harrisontidy/pickleball-robot/SCHEMATIC_GUIDE.md

# Pickleball robot controller schematic guide

This guide describes revision **R2-MULTISHEET**. The source of truth is `generate_kicad_multisheet.py`; the generated KiCad project is `pickleball_robot_controller.kicad_pro`.

## Sheet map

1. `00_battery_safety.kicad_sch` — XT60, main fuse, LTC4365 whole-board cutoff, E-stop relay wiring, actuator TVS, and battery ADC.
2. `01_power_and_pi.kicad_sch` — 5 V logic supply and 5.1 V Raspberry Pi supply.
3. `02_esp32_and_pi.kicad_sch` — ESP32-PICO-KIT V4.1 carrier, Pi UART/control header, fault aggregation, optional I2C links, status LEDs, and debug points.
4. `03_left_motor.kicad_sch` — left VNH5019 driver, branch fuse, current-sense protection, motor/encoder connector, and large motor-wire pads.
5. `04_right_motor.kicad_sch` — right channel, matching the left channel.
6. `05_encoder_inputs.kicad_sch` — filtered encoder 3.3 V rail, cable resistors, four Schmitt buffers, local bypass capacitors, and test points.
7. `06_arm_servos.kicad_sch` — 6 V servo buck, PCA9685, three AHCT level buffers, and three independent PWM outputs.
8. `07_main_servo_8v4.kicad_sch` — dedicated 8.4 V rail for the Miuzei main-swing servo.

J1 uses the KiCad AMASS XT60PW-M footprint's actual polarity: pin 1 is negative/GND and pin 2 is positive/BAT_RAW. Do not reverse these to match a generic two-pin connector convention.

## Canonical ESP32 pin map

| Function | ESP32 GPIO |
|---|---:|
| PCA9685 SDA / SCL | 21 / 22 |
| Raspberry Pi UART RX / TX | 18 / 19 |
| Aggregated motor fault | 23 |
| Servo PWM output-enable | 32 |
| Left PWM / INA / INB | 25 / 26 / 27 |
| Right PWM / INA / INB | 14 / 13 / 4 |
| Battery ADC | 33 |
| Left / right current ADC | 36 / 39 |
| Left encoder A / B | 34 / 35 |
| Right encoder A / B | 37 / 38 |

GPIO2 is no longer used for servo OE, GPIO5 is deliberately unused, and UART0 GPIO1/3 remains free for the board's USB programming bridge.

## Raspberry Pi headers

J9 is the high-current Pi power connector: pins 1–2 are `PI_5V`, pins 3–4 are ground. It is a Molex Mini-Fit Jr 2x2 right-angle header. The Pi must not be powered from USB-C at the same time.

J10 is a normal 1x8 2.54 mm header:

| J10 | Signal | Raspberry Pi connection |
|---:|---|---|
| 1 | GND | any Pi ground |
| 2 | GND | second return wire |
| 3 | Pi TX to ESP GPIO18 | GPIO14, physical pin 8 |
| 4 | ESP GPIO19 to Pi RX | GPIO15, physical pin 10 |
| 5 | `SERVO_POWER_ENABLE` | GPIO17, physical pin 11 |
| 6 | aggregated motor fault | GPIO27, physical pin 13 |
| 7 | optional I2C SDA | GPIO2, physical pin 3; DNP R43 must be fitted |
| 8 | optional I2C SCL | GPIO3, physical pin 5; DNP R44 must be fitted |

J20 is a DNP bench override connected through R46 4.7 kΩ, so it cannot hard-short a Pi GPIO driven low. Leave it unpopulated for normal Pi control.

On Raspberry Pi 5, enable the primary UART with `dtoverlay=uart0-pi5` and disable the Linux serial console before using J10. Never assume the Pi 5 UART mapping matches older Pi models.

## Wheel-motor connections

J4 and J5 are JST-PH 2.00 mm six-pin headers matching the photographed cable order:

| Pin | Wire | Function |
|---:|---|---|
| 1 | red | motor OUTA |
| 2 | black | encoder ground |
| 3 | yellow | encoder A |
| 4 | green | encoder B |
| 5 | blue | filtered encoder 3.3 V |
| 6 | white | motor OUTB |

J15/J16 are the primary 1.7 mm through-hole motor-power pads. JST-PH motor pins 1/6 are isolated by normally-open JP1–JP4 solder jumpers. Leave the jumpers open with heavy motor wires; bridge them only for low-current bench tests. Fit external C18/C19 directly across each motor's red/white terminals.

Each driver has a 5 A mini-blade branch fuse, 10 kΩ safe-state pull-downs, 1 kΩ control resistors, separate diagnostics, 35 V local bulk plus ceramic bypass, and a protected current ADC. The VNH5019 custom footprint keeps exposed pads 31, 32, and 33 electrically separate and gives each its own windowed paste and thermal-via field.

## Servo system

U5 is a PCA9685. LED0, LED1, and LED2 generate independent commands; all three share a 50 Hz frame rate but can have different pulse widths.

| Header | Servo | Power | Pin order |
|---|---|---:|---|
| J12 | Miuzei 25KG 270° main swing | 8.4 V | 1 GND, 2 power, 3 PWM |
| J13 | MG996R elbow | 6 V | 1 GND, 2 power, 3 PWM |
| J14 | MG90S wrist | 4.85 V | 1 GND, 2 power, 3 PWM |

These hobby servos contain an internal control loop and position sensor, but they do not return their measured position to the ESP32 through the normal three-wire connector.

`SERVO_POWER_ENABLE` defaults low and controls both servo-regulator EN pins. PCA9685 OE also defaults disabled. This gives two startup safeguards: no servo power until the Pi enables it, and no PWM until the ESP32 enables outputs.

U13–U15 are SN74AHCT1G125 buffers powered from `WRIST_4V85`. AHCT inputs accept the PCA9685's 3.3 V high level and produce 4.85 V PWM at every servo header. Their active-low OE pins share `GPIO32_SERVO_OE`, so they are high-impedance whenever the PCA outputs are disabled; removing servo power also removes buffer power.

## Power rails

- `BAT_FUSED`: battery voltage immediately after F1.
- `VBAT_SW`: whole-board protected supply after U12/Q5/Q6.
- `ACT_VBAT`: battery supply after the external latching E-stop loop, used by motors and both servo regulators.
- `+5V_CTRL`: ESP32 and logic only.
- `PI_5V`: approximately 5.1 V, up to 5 A design target.
- `SERVO_6V`: 6.0 V rail for J13 and input to the wrist LDO.
- `WRIST_4V85`: dedicated fused 4.85 V rail for J14 MG90S.
- `MAIN_SERVO_8V4`: 8.4 V rail for J12.
- `ENC_3V3`: ferrite-filtered encoder supply.

U12 disconnects below approximately 9.62 V, reconnects near 10.10 V, and trips overvoltage near 13.79 V. It is a whole-pack discharge cutoff, not a balance charger or per-cell BMS. The TPS54560 networks use corrected feedback, EN, catch-diode, and compensation connections. C30/C40/C61 and the three RC snubbers are real KiCad DNP parts; do not populate optional bulk/snubber parts until loop and switch-node measurements justify them.

For the E-stop, use J21.1 -> Schneider XB5AS8442 NC button -> Panasonic CB1aF-RM-12V-A-5 relay coil -> J21.2. Connect the relay NO contact across J18. This keeps high actuator current out of the push-button and makes a broken coil wire stop the actuators.

## PCB rules that are not optional

- Four-layer board strongly preferred: signal/power, solid ground, power distribution, signal/power.
- Use 2 oz outer copper if practical.
- Keep every buck input-capacitor/IC/diode loop extremely small; keep switch nodes away from ESP antenna, UART, ADC, and encoder traces.
- Use Kelvin feedback routing from the output-capacitor node.
- Put the ESP antenna beyond the board edge if possible. The footprint enforces F/B keepouts; also create matching inner-layer keepouts when the four-layer PCB is created.
- Use separate high-current actuator branches from a star point; do not route motor/servo return current through the logic ground path.
- Widen motor and rail copper with pours, not only traces. Verify current width using the board house's actual copper thickness and allowed temperature rise.
- Add mounting holes, motor-wire strain relief, connector pin-1 legends, fuse ratings, rail names, and polarity on silkscreen.
- Run ERC, PCB DRC, netlist comparison, Gerber inspection, drill inspection, and paste-window inspection before ordering.

## Known design gates before manufacture

1. Measure actual motor stall current or keep the conservative 5 A branch-fuse/copper allowance.
2. Confirm every physical connector and servo SKU against the purchased part.
3. Choose exact output MLCCs and verify their effective capacitance at 5.1 V, 6 V, and 8.4 V.
4. Bench-test U12 cutoff, reconnect, reverse isolation, Q5/Q6 temperature, and the complete E-stop relay harness.
5. Bench-test regulator startup and transient response on the first PCB with a current-limited supply and dummy loads.
6. Firmware must use calibrated current sense and a short overcurrent timeout. The 5 A motor fuses protect wiring, not the small motors.
