harrisontidy/pickleball-robot/pickleball_robot_controller.pdf

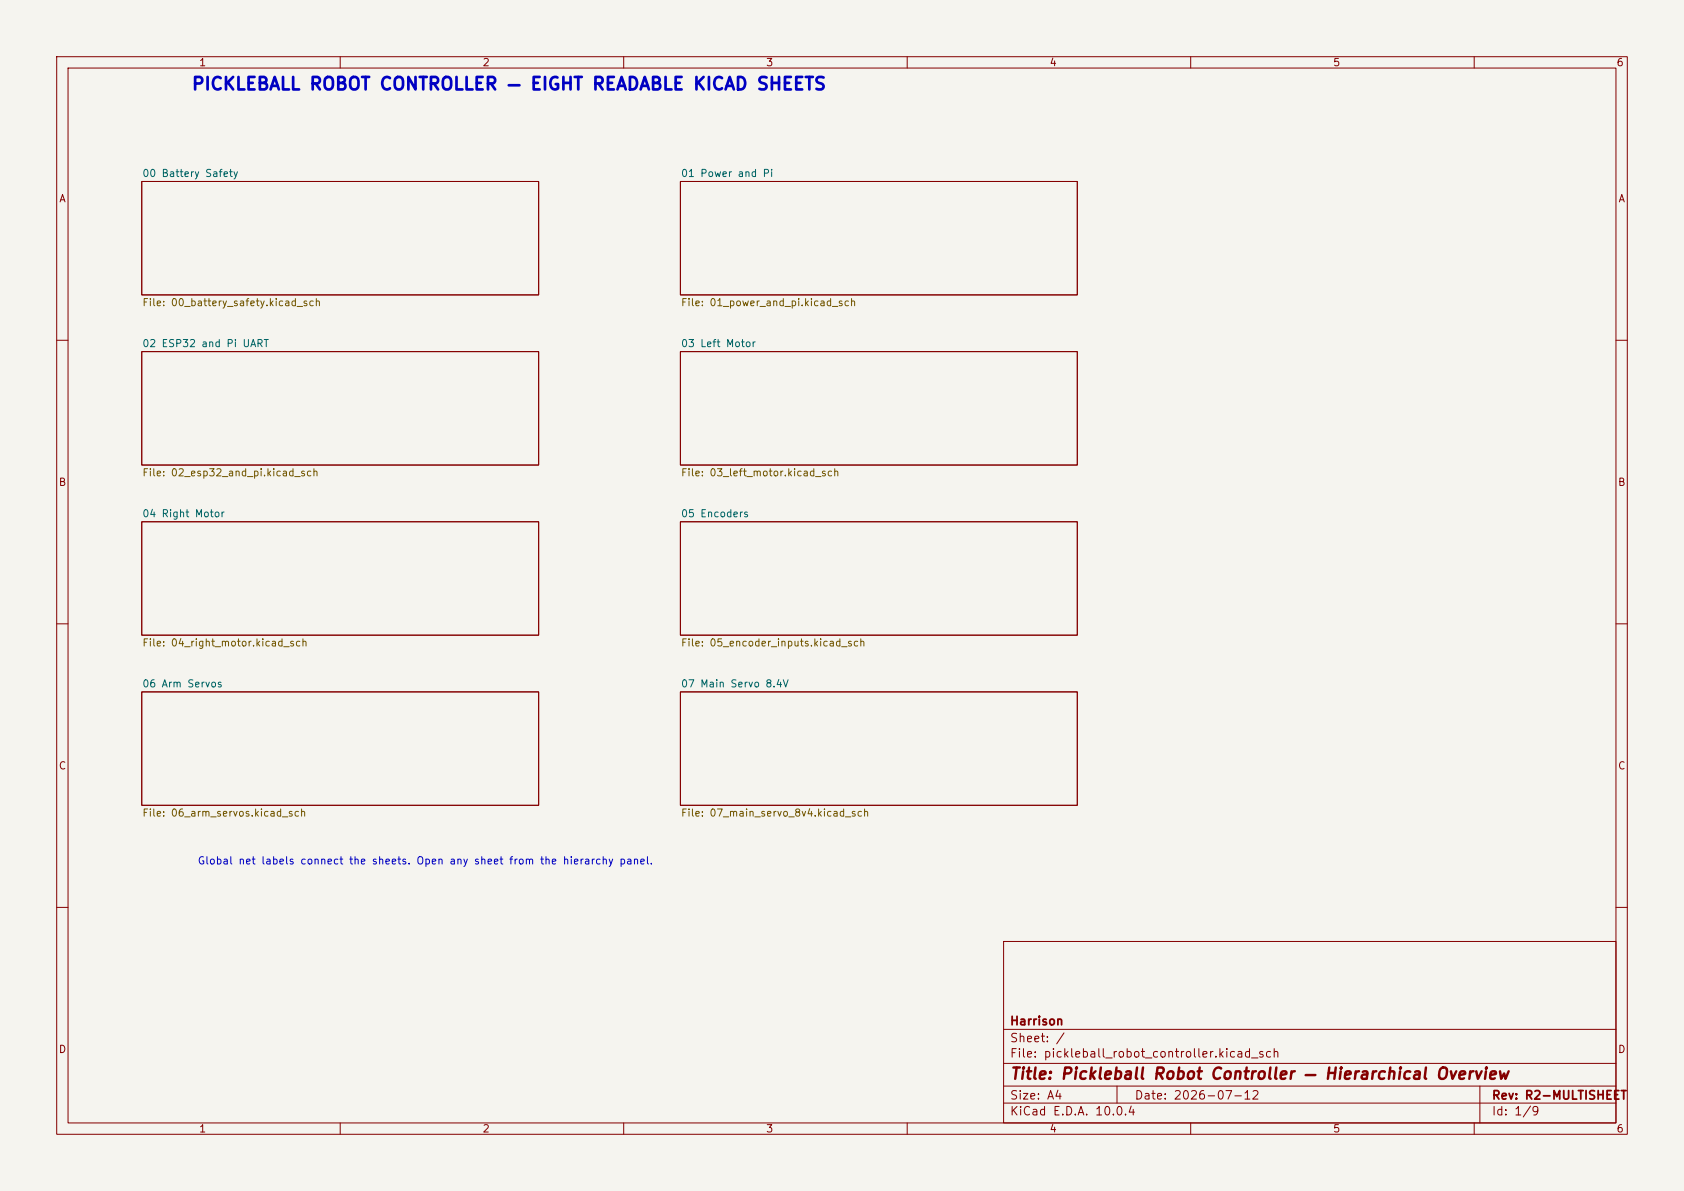
[picture p1: page 1]

01 Power and Pi File: 01_power_and_pi.kicad_sch 03 Left Motor File: 03_left_motor.kicad_sch 05 Encoders File: 05_encoder_inputs.kicad_sch 07 Main Servo 8.4V

00 Battery Safety File: 00_battery_safety.kicad_sch 02 ESP32 and Pi UART File: 02_esp32_and_pi.kicad_sch 04 Right Motor File: 04_right_motor.kicad_sch 06 Arm Servos File: 06_arm_servos.kicad_sch PICKLEBALL ROBOT CONTROLLER — EIGHT READABLE KICAD SHEETS

Global net labels connect the sheets. Open any sheet from the hierarchy panel.

Harrison
Sheet: /
File: pickleball_robot_controller.kicad_sch
Title: Pickleball Robot Controller — Hierarchical Overview
KiCad E.D.A. 10.0.4

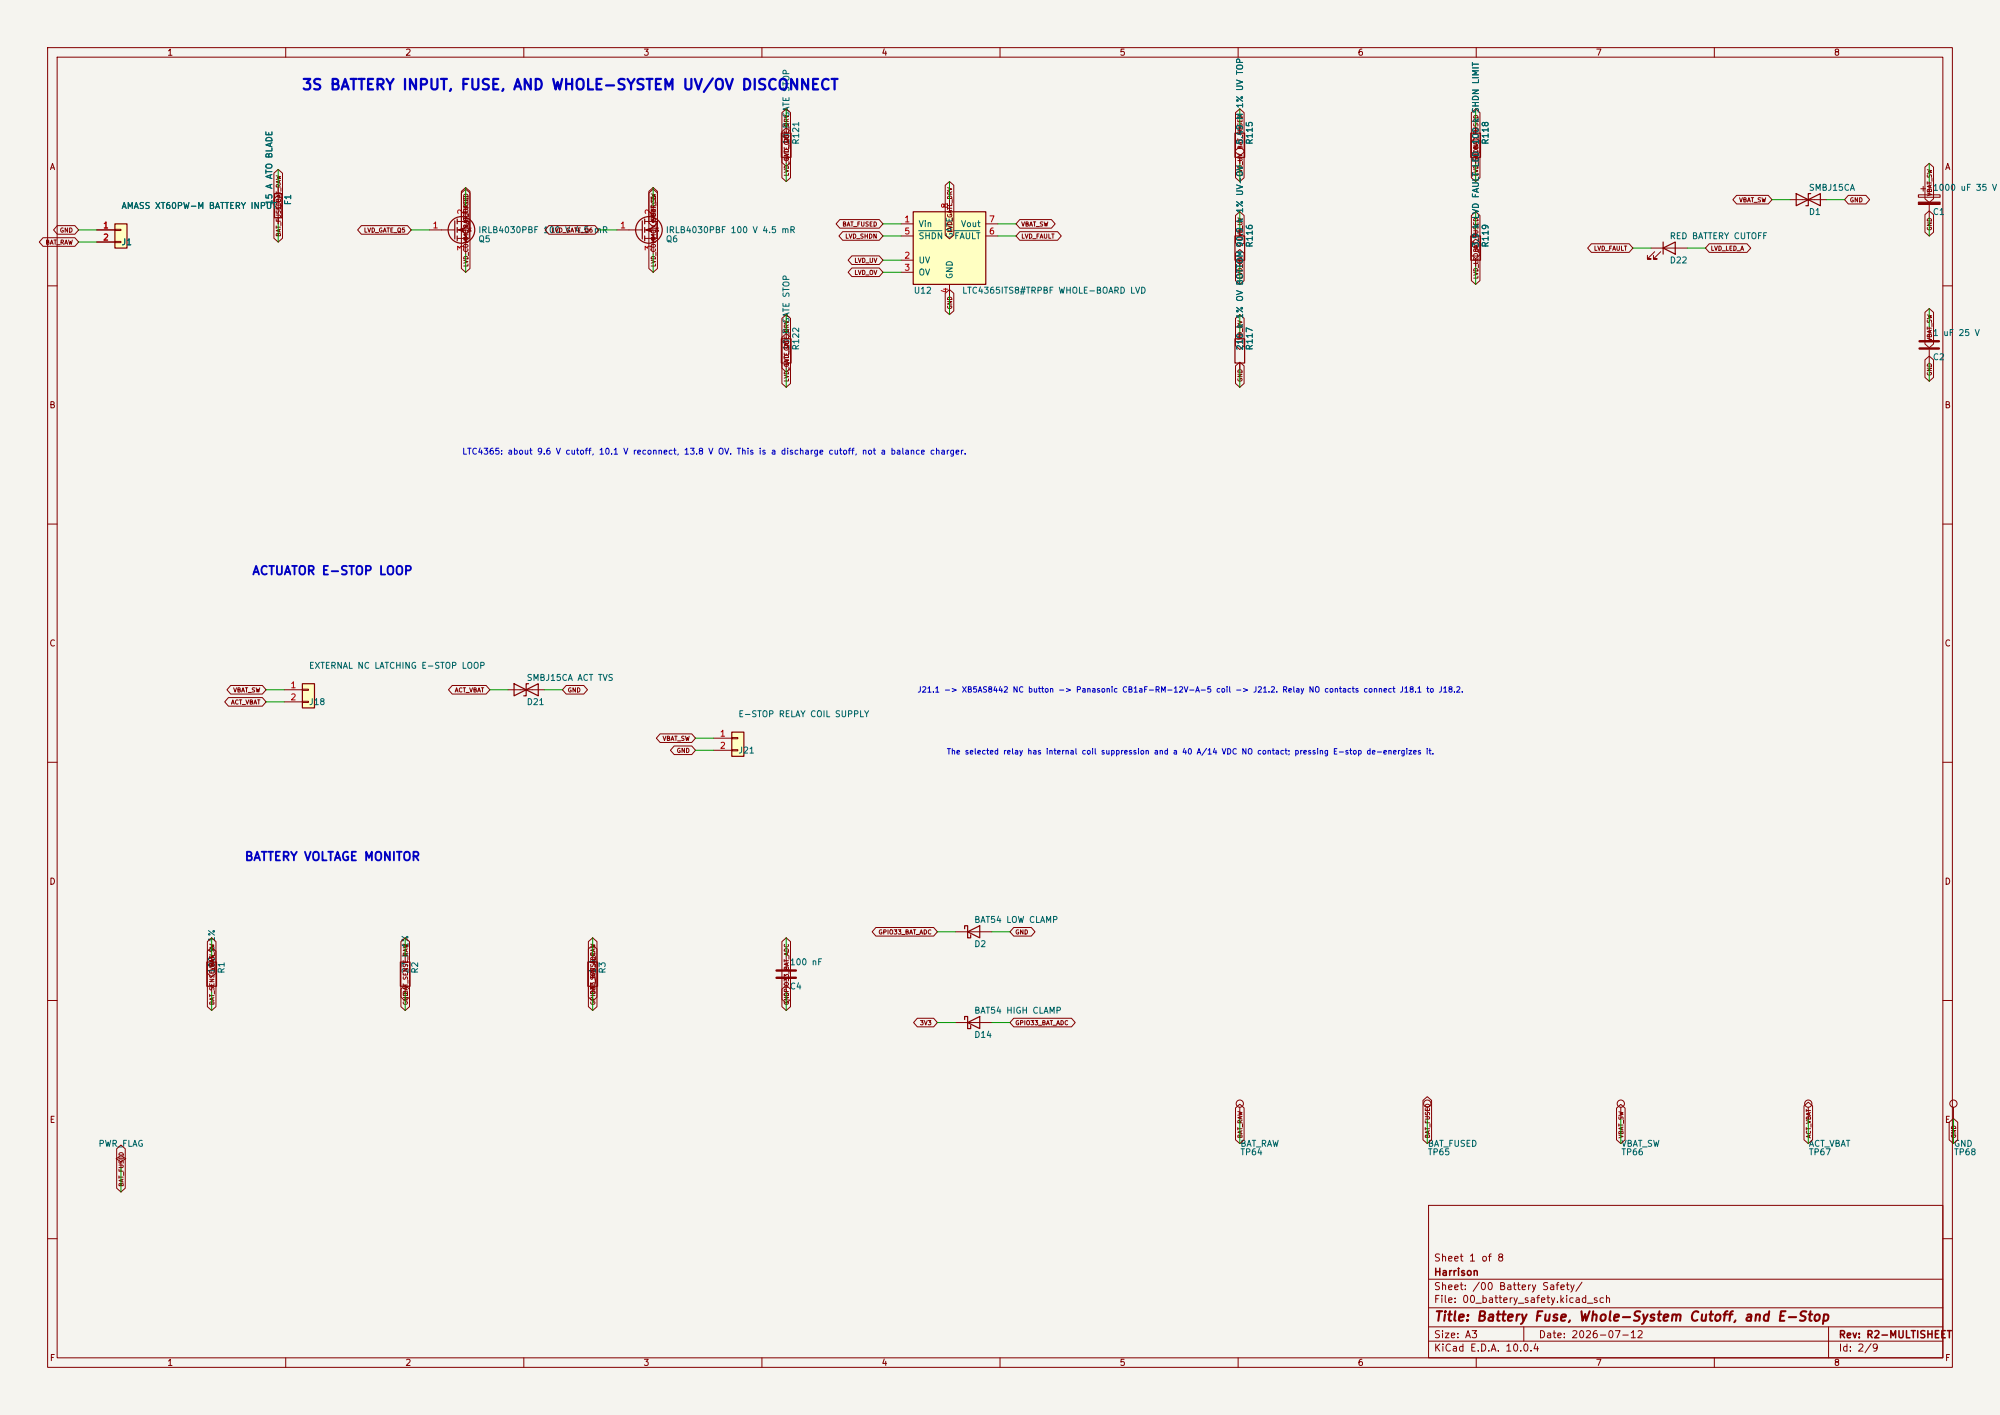
[picture p2: page 2]

J21.1 -> XB5AS8442 NC button -> Panasonic CB1aF-RM-12V-A-5 coil -> J21.2. Relay NO contacts connect J18.1 to J18.2. The selected relay has internal coil suppression and a 40 A/14 VDC NO contact; pressing E-stop de-energizes it. 3S BATTERY INPUT, FUSE, AND WHOLE-SYSTEM UV/OV DISCONNECT

LTC4365: about 9.6 V cutoff, 10.1 V reconnect, 13.8 V OV. This is a discharge cutoff, not a balance charger.

EXTERNAL NC LATCHING E-STOP LOOP

Harrison
Sheet: /00 Battery Safety/
File: 00_battery_safety.kicad_sch
Title: Battery Fuse, Whole-System Cutoff, and E-Stop

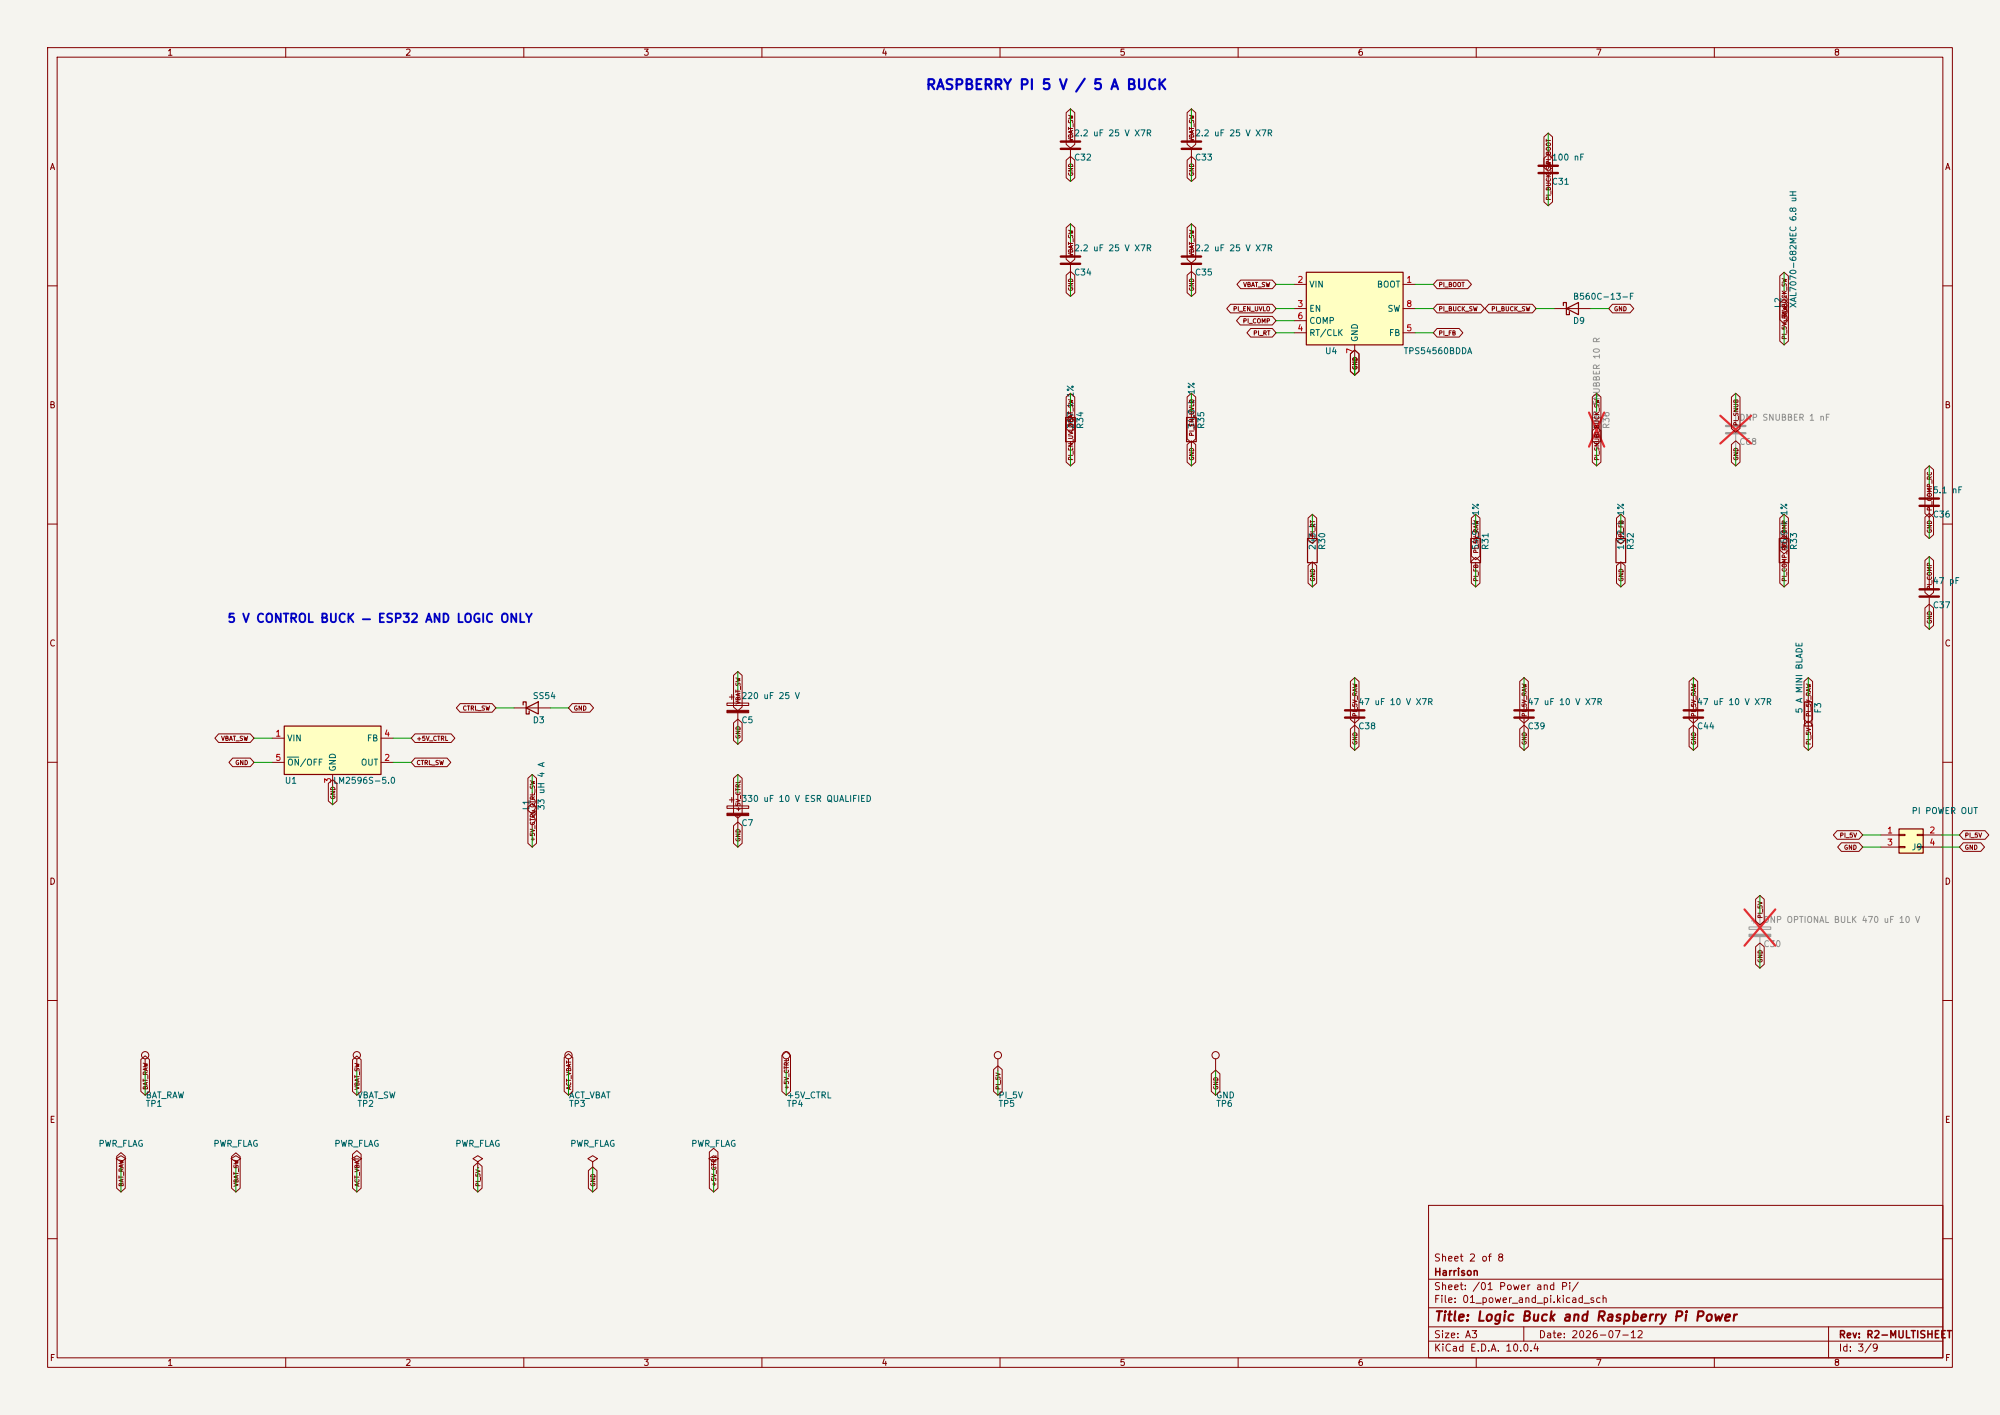
[picture p3: page 3]

k C30 DNP OPTIONAL BULK 470 uF 10 V

5 V CONTROL BUCK — ESP32 AND LOGIC ONLY

Sheet 2 of 8
Harrison
Sheet: /01 Power and Pi/
File: 01_power_and_pi.kicad_sch
Title: Logic Buck and Raspberry Pi Power

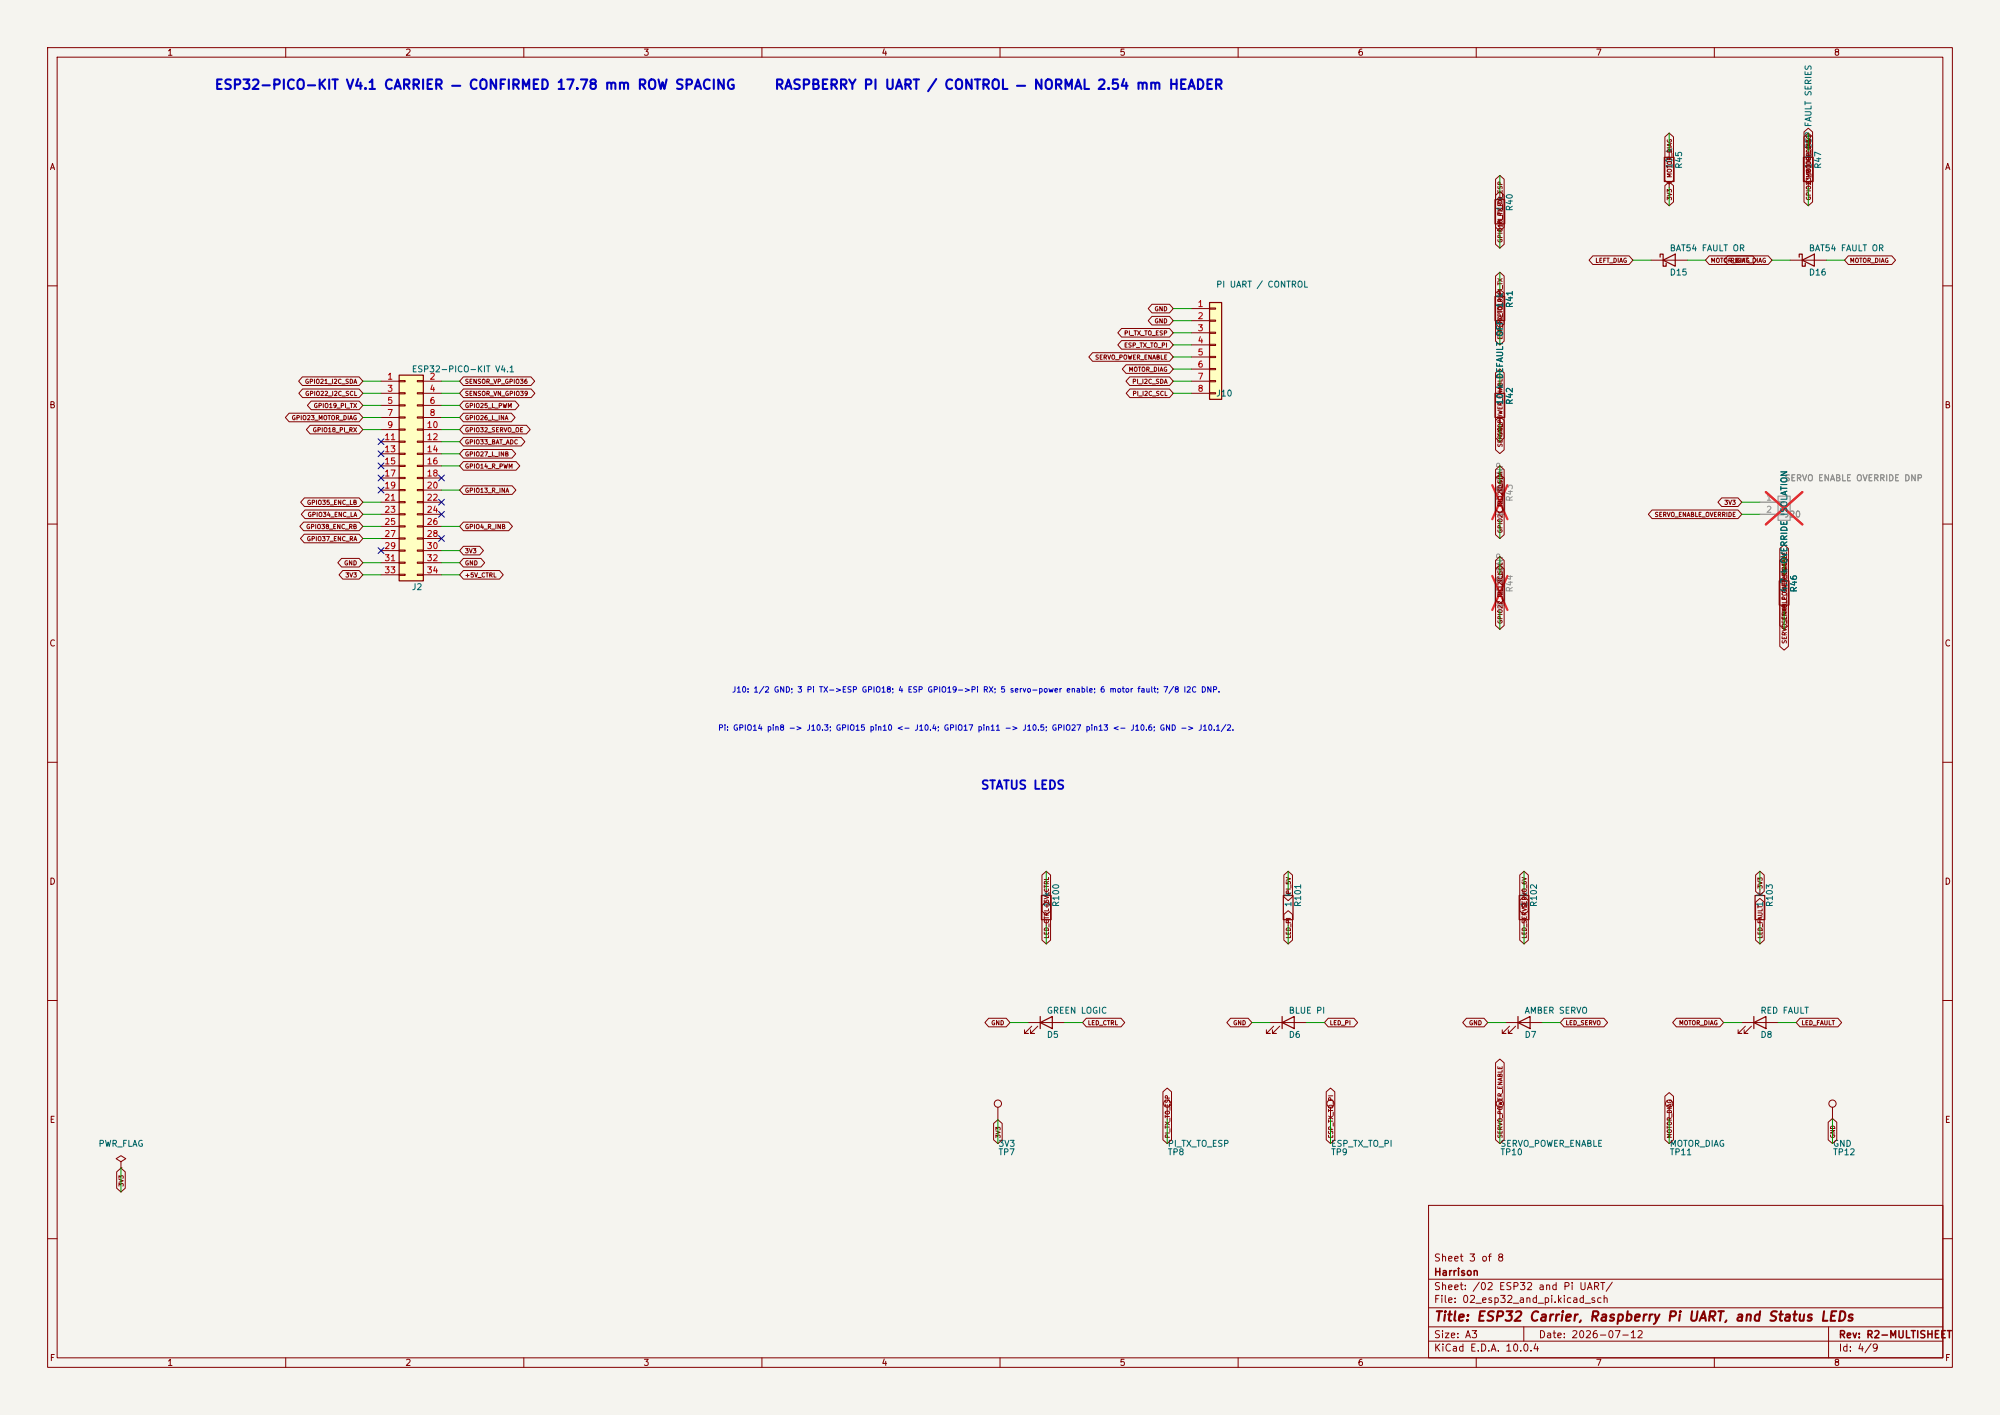
[picture p4: page 4]

SERVO ENABLE OVERRIDE DNP 1 R47k ESP FAULT SERIES 0 R44R DNP
ESP_TX_TO_PI SERVO_POWER_ENABLE MOTOR_DIAG STATUS LEDS

SERVO ENABLE OVERRIDE DNP

Pi: GPIO14 pin8 -> J10.3; GPIO15 pin10 <- J10.4; GPIO17 pin11 -> J10.5; GPIO27 pin13 <- J10.6; GND -> J10.1/2. J10: 1/2 GND; 3 Pi TX->ESP GPIO18; 4 ESP GPIO19->Pi RX; 5 servo-power enable; 6 motor fault; 7/8 I2C DNP.

Harrison
Sheet: /02 ESP32 and Pi UART/
File: 02_esp32_and_pi.kicad_sch
Title: ESP32 Carrier, Raspberry Pi UART, and Status LEDs

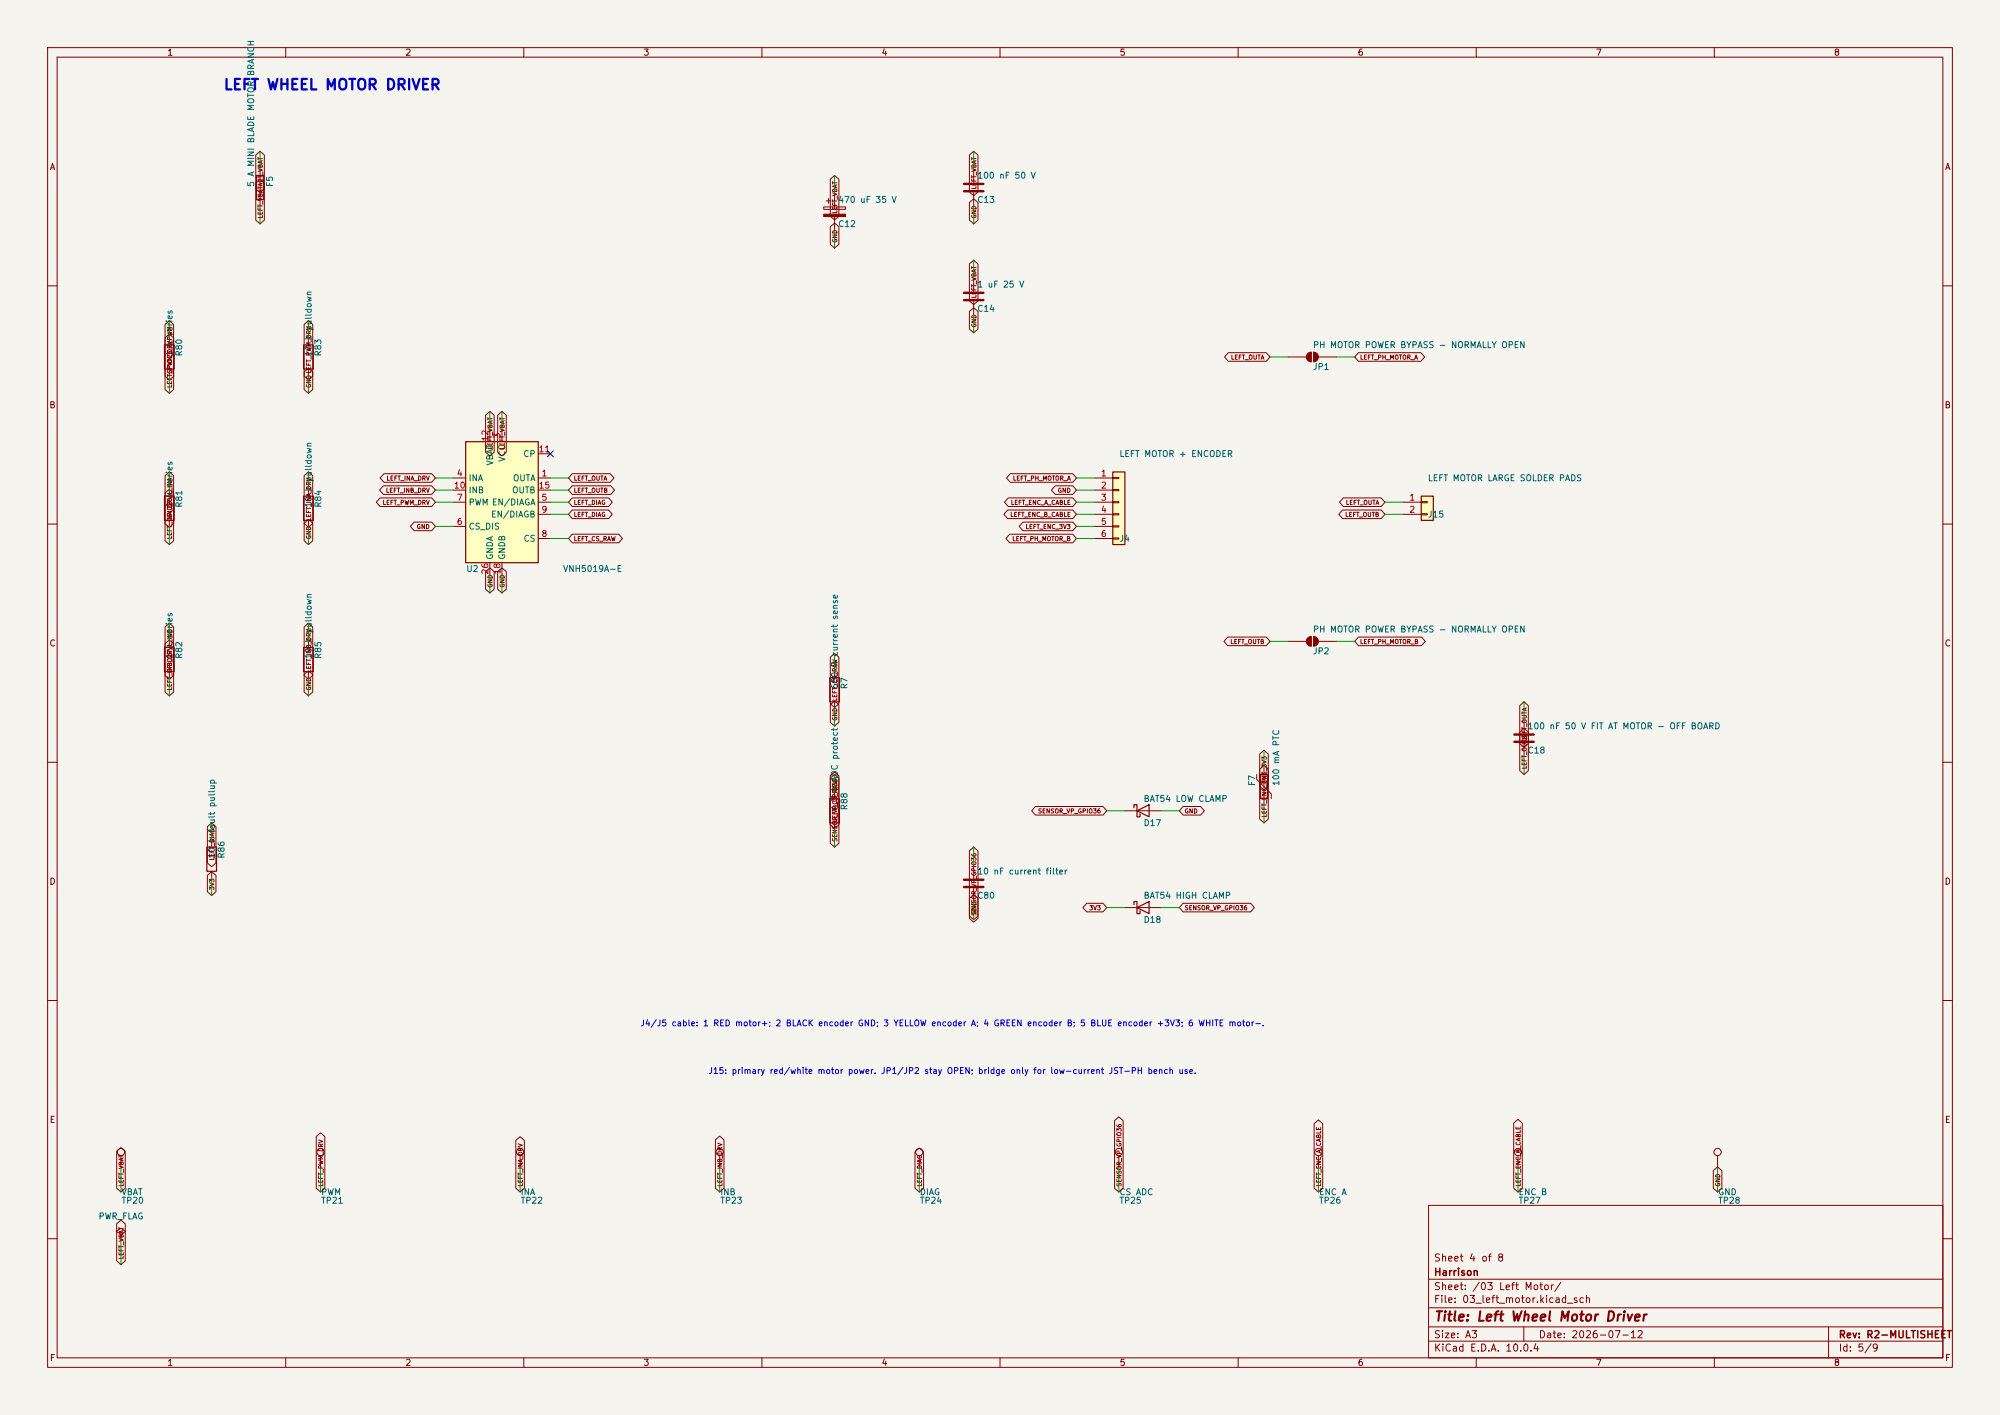
[picture p5: page 5]

LEFT WHEEL MOTOR DRIVER

LEFT MOTOR LARGE SOLDER PADS C12

100 nF 50 V FIT AT MOTOR - OFF BOARD 10 R83k pulldown 10 R84k pulldown

10 nF current filter 1 R81k series 1 R80k series

JP1 PH MOTOR POWER BYPASS - NORMALLY OPEN

JP2 PH MOTOR POWER BYPASS - NORMALLY OPEN

J4/J5 cable: 1 RED motor+; 2 BLACK encoder GND; 3 YELLOW encoder A; 4 GREEN encoder B; 5 BLUE encoder +3V3; 6 WHITE motor-. J15: primary red/white motor power. JP1/JP2 stay OPEN; bridge only for low-current JST-PH bench use.

Harrison
Sheet: /03 Left Motor/
File: 03_left_motor.kicad_sch
Title: Left Wheel Motor Driver

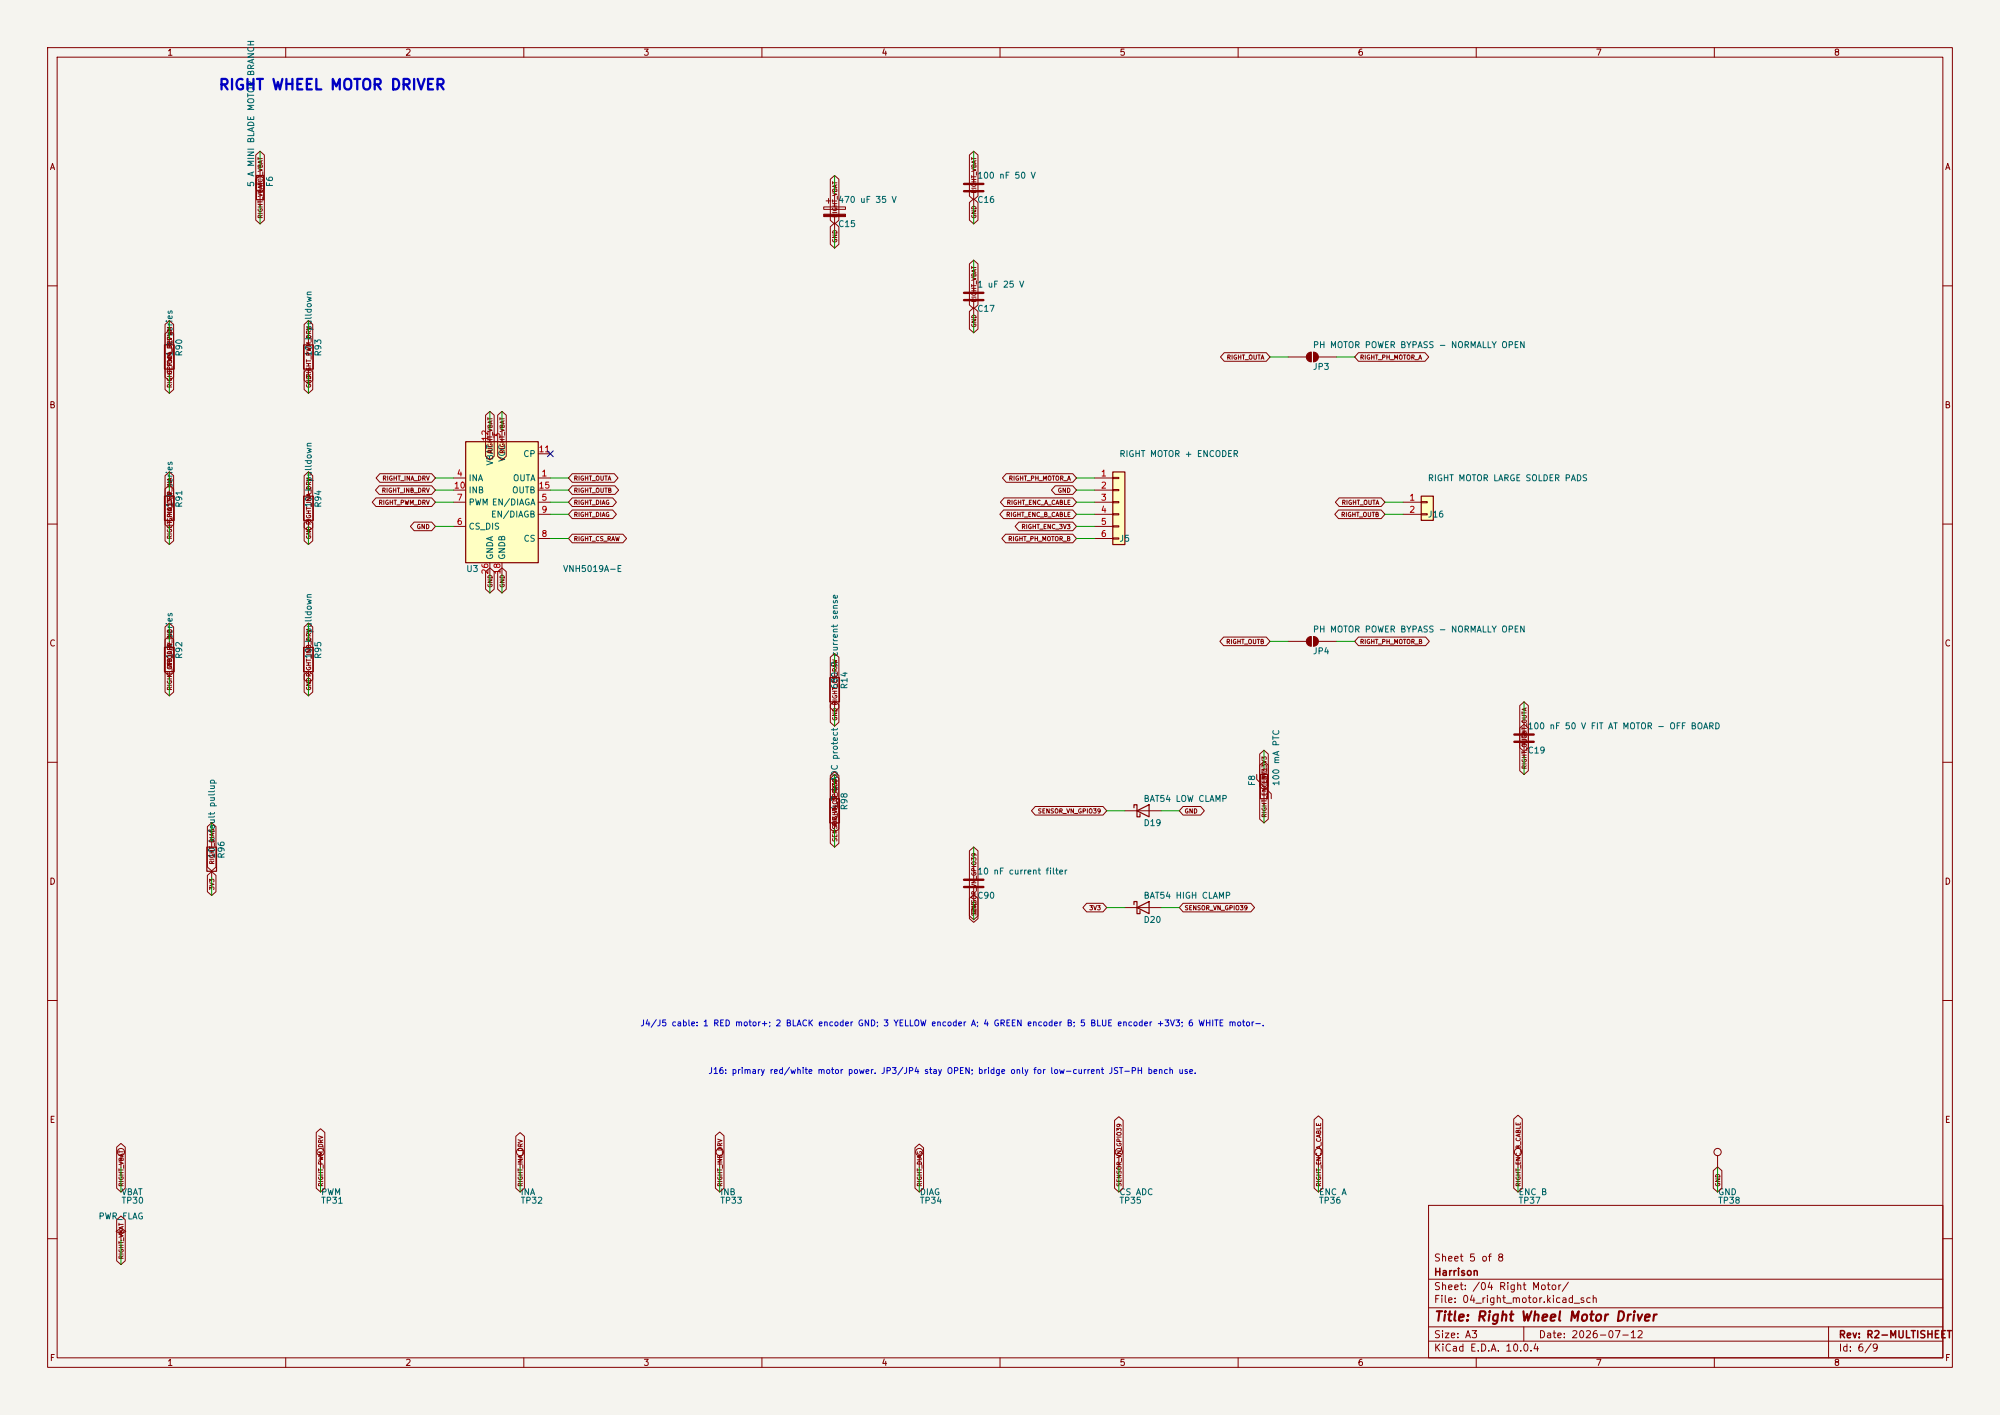
[picture p6: page 6]

JP4 PH MOTOR POWER BYPASS - NORMALLY OPEN 680 R14 R current sense C15

JP3 PH MOTOR POWER BYPASS - NORMALLY OPEN

J5RIGHT MOTOR + ENCODER 4.7 R98 k ADC protect

100 nF 50 V FIT AT MOTOR - OFF BOARD 1 R92k series

J16: primary red/white motor power. JP3/JP4 stay OPEN; bridge only for low-current JST-PH bench use. J4/J5 cable: 1 RED motor+; 2 BLACK encoder GND; 3 YELLOW encoder A; 4 GREEN encoder B; 5 BLUE encoder +3V3; 6 WHITE motor-.

Sheet 5 of 8
Harrison
Sheet: /04 Right Motor/
File: 04_right_motor.kicad_sch
Title: Right Wheel Motor Driver

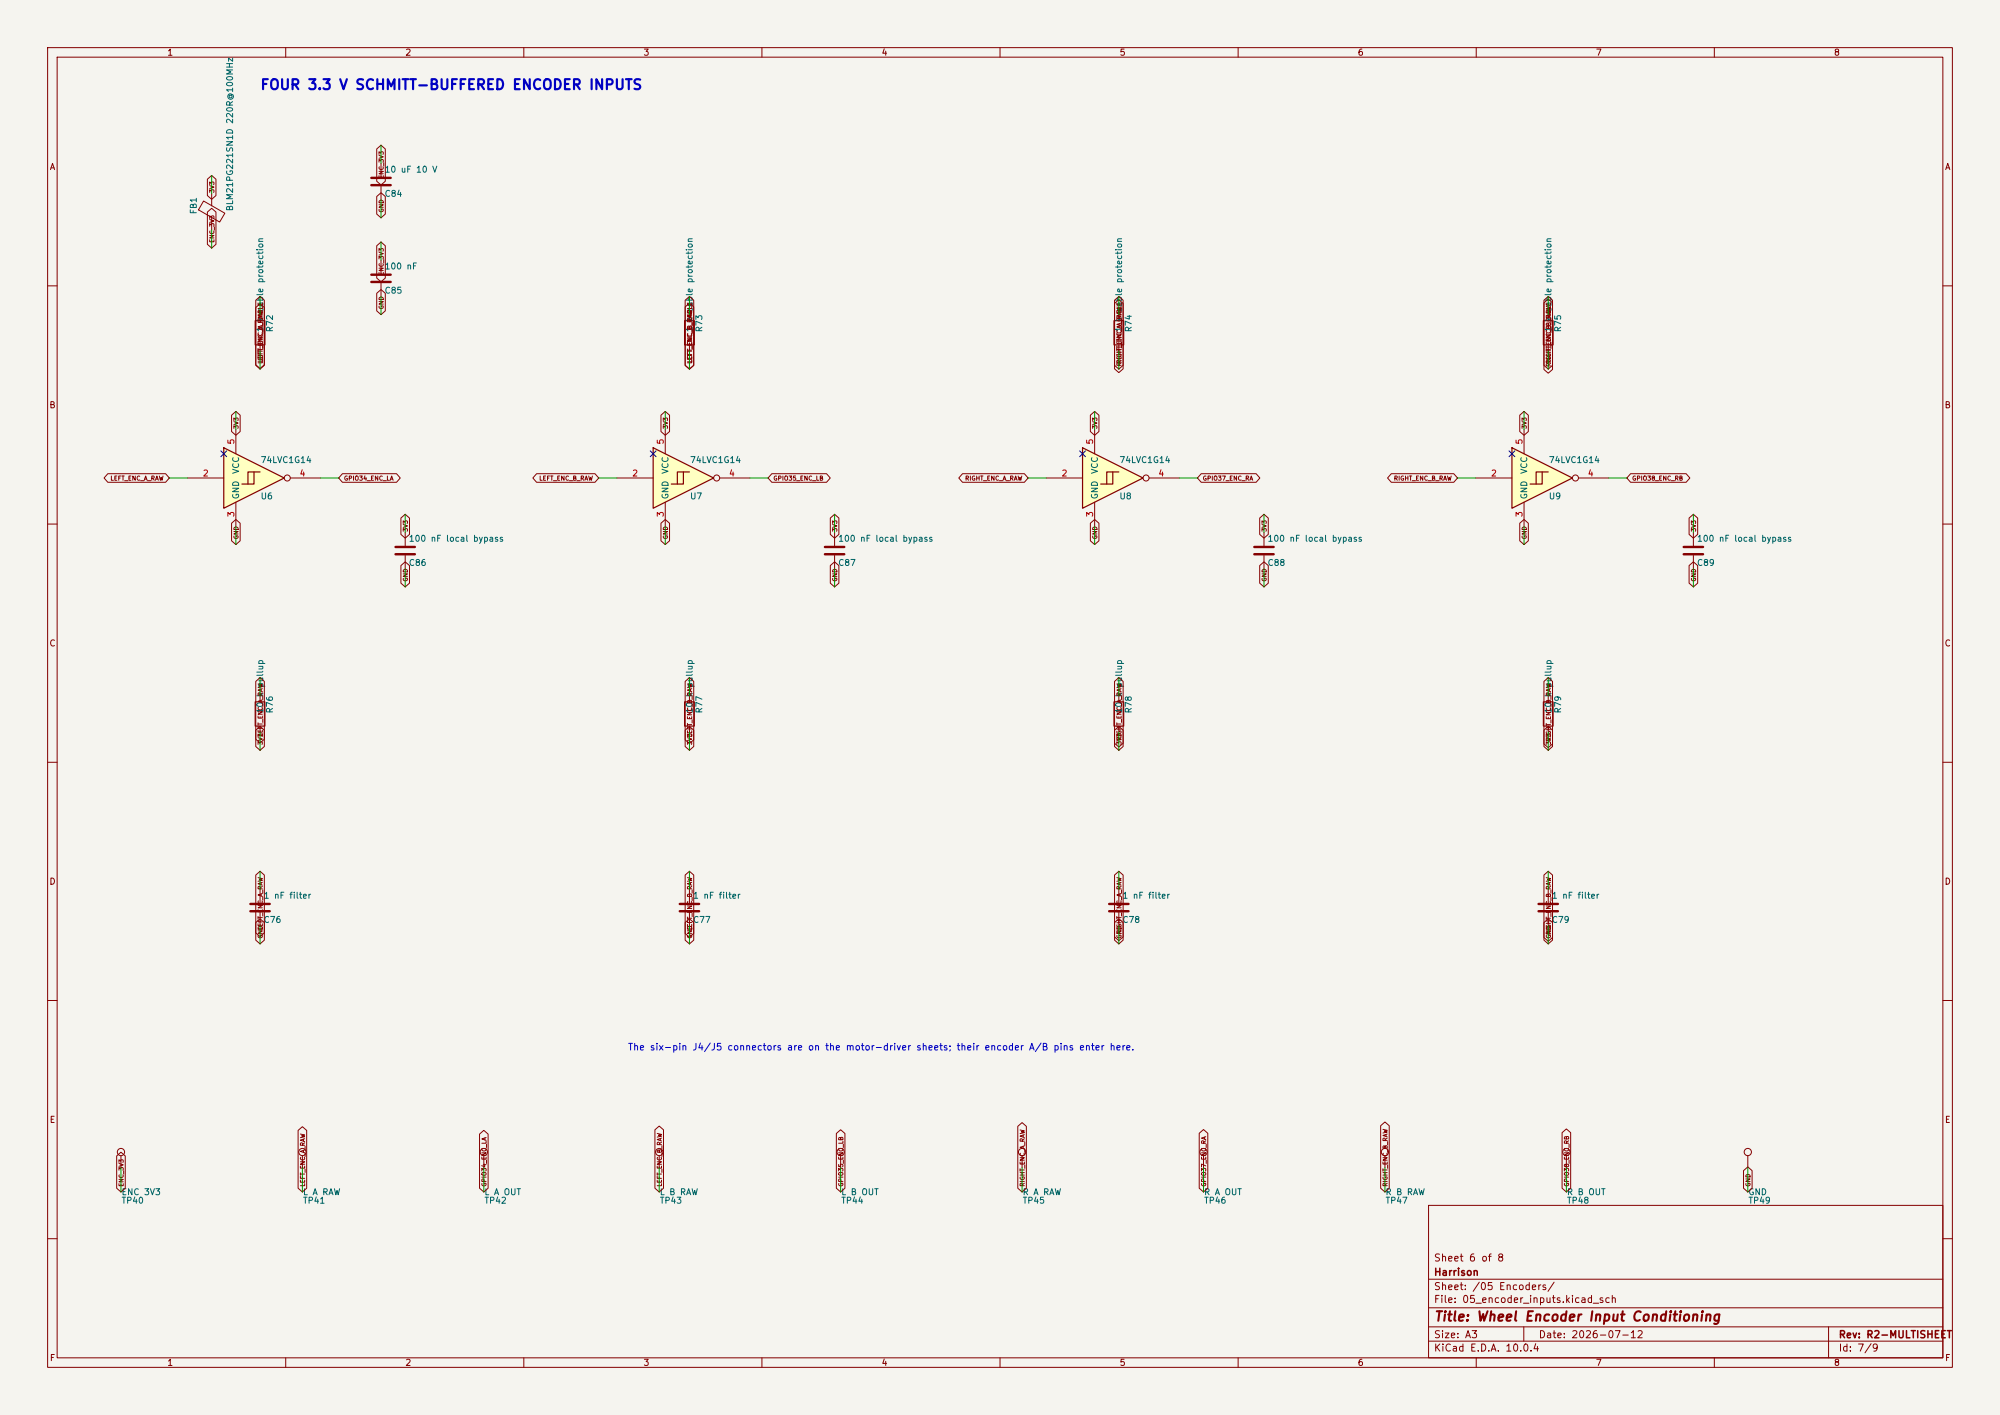
[picture p7: page 7]

FOUR 3.3 V SCHMITT-BUFFERED ENCODER INPUTS

Sheet 6 of 8
Harrison
Sheet: /05 Encoders/
File: 05_encoder_inputs.kicad_sch
Title: Wheel Encoder Input Conditioning

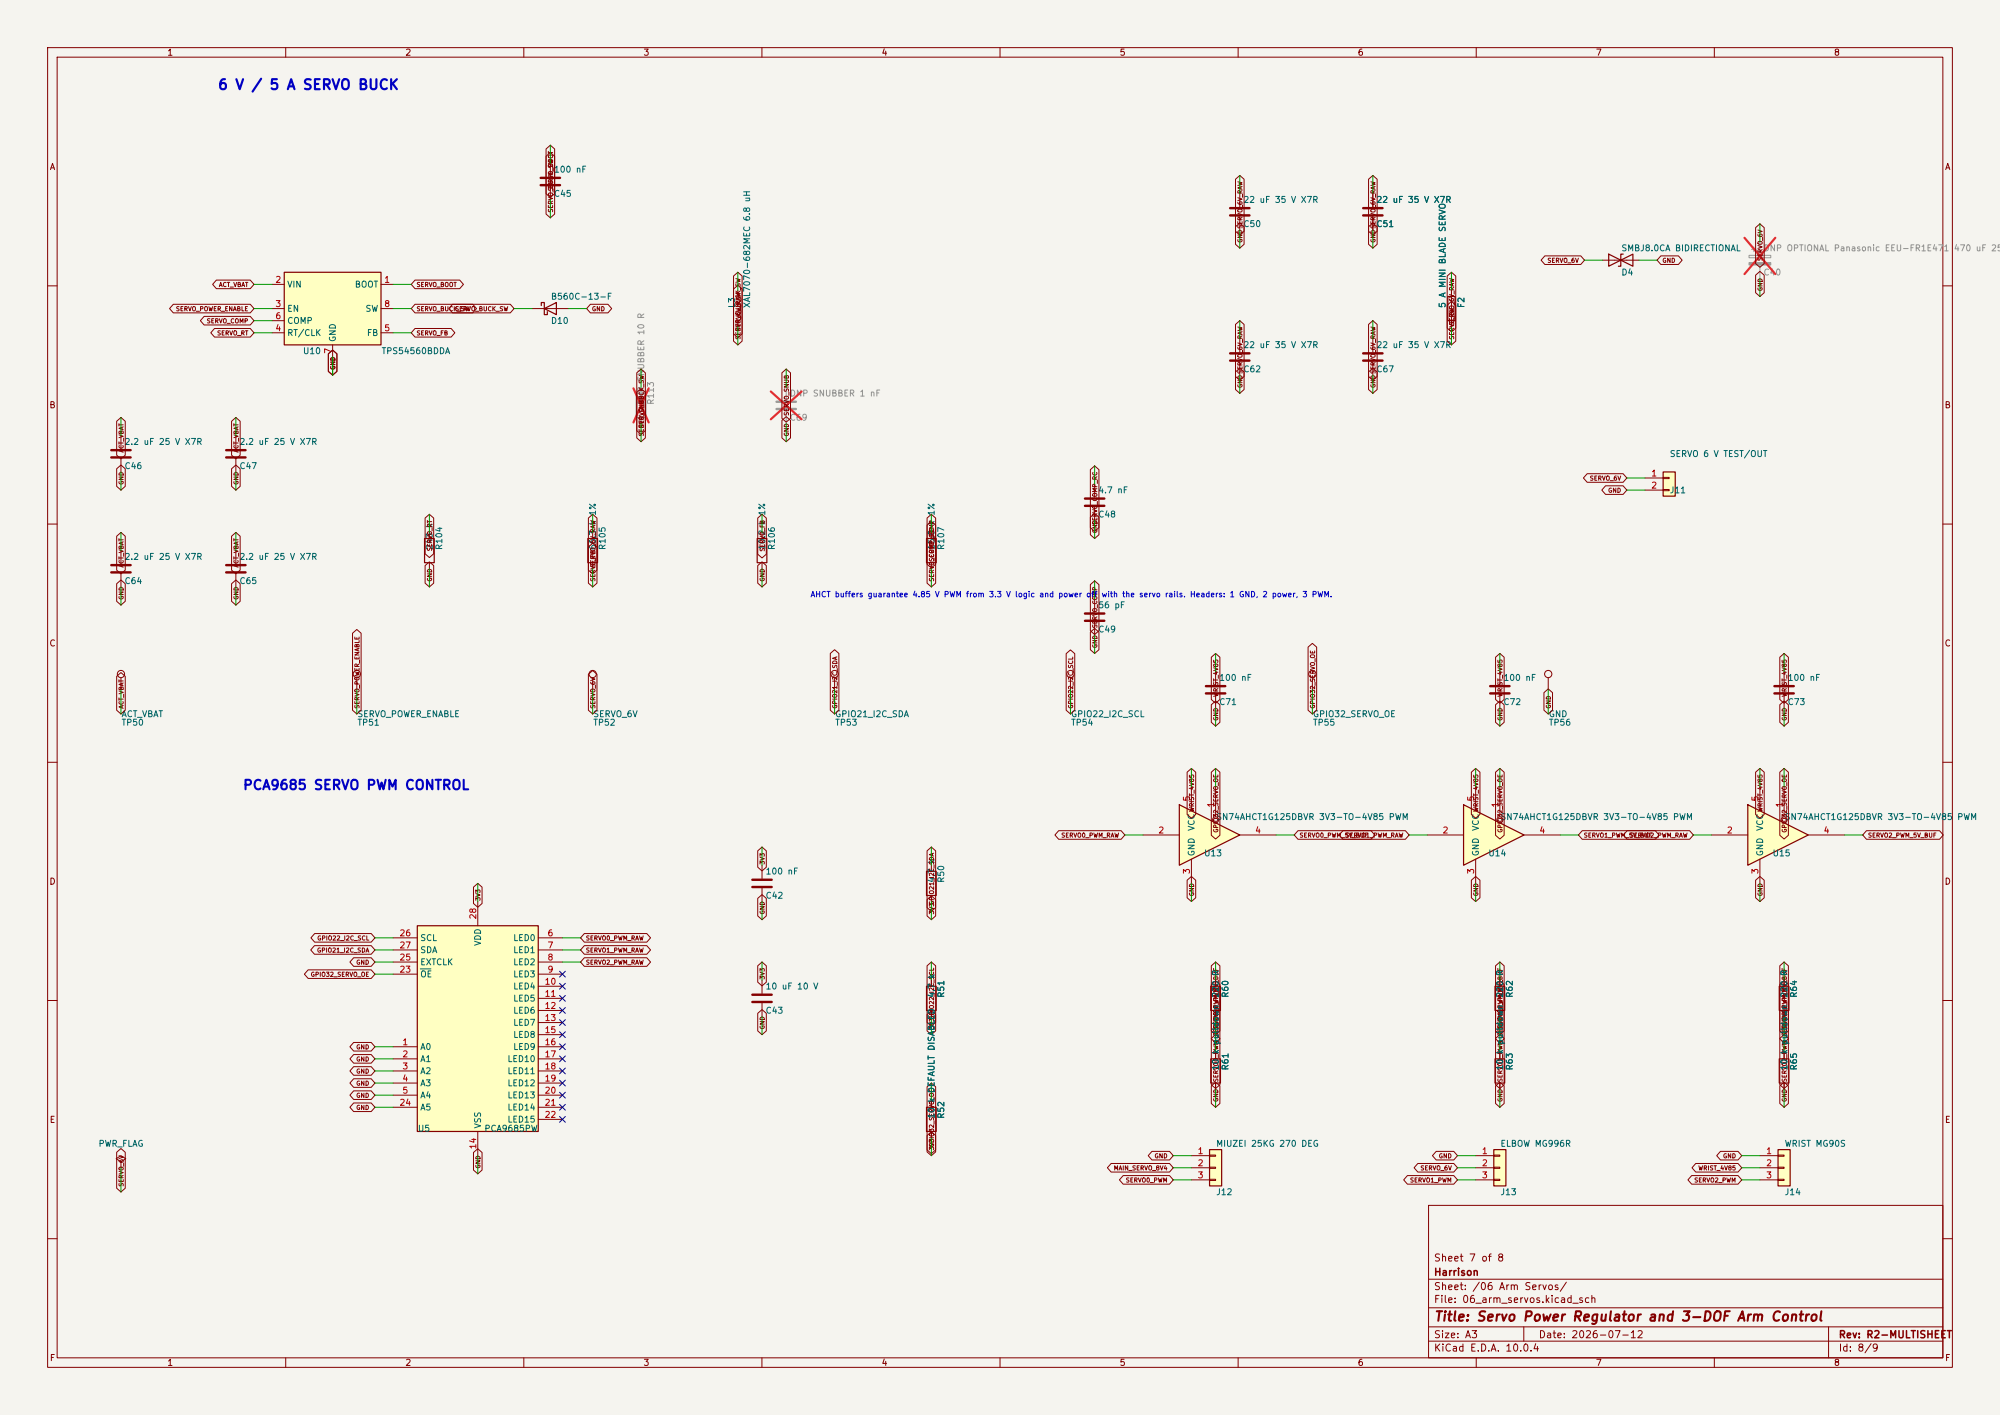
[picture p8: page 8]

C40 DNP OPTIONAL Panasonic EEU-FR1E471 470 uF 25 V

Sheet 7 of 8
Harrison
Sheet: /06 Arm Servos/
File: 06_arm_servos.kicad_sch
Title: Servo Power Regulator and 3-DOF Arm Control

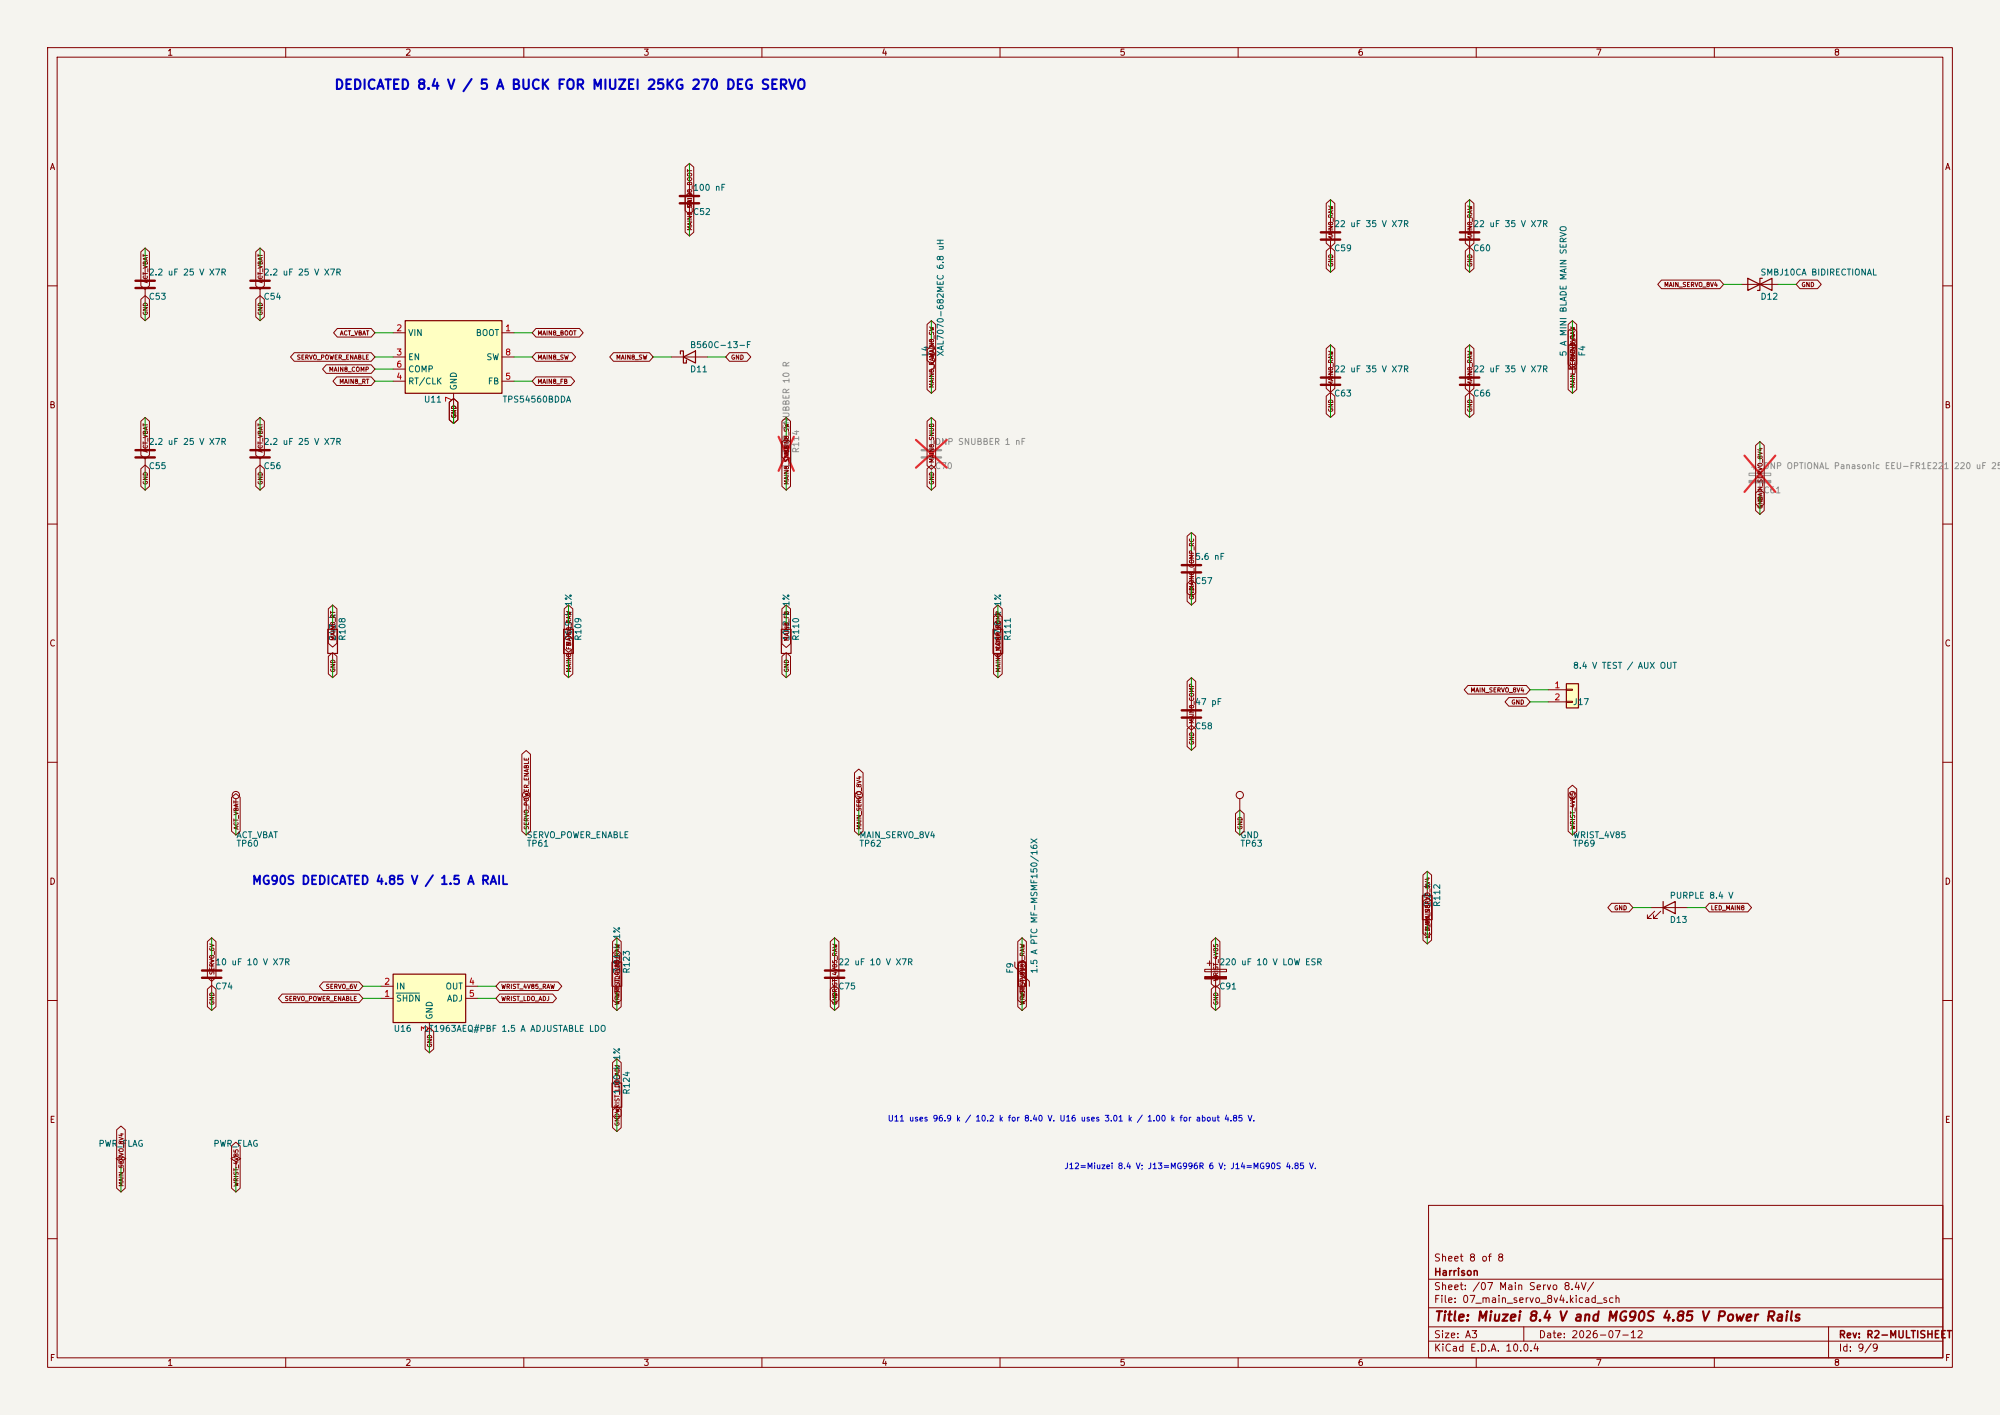
[picture p9: page 9]

DEDICATED 8.4 V / 5 A BUCK FOR MIUZEI 25KG 270 DEG SERVO

Sheet 8 of 8
Harrison
Sheet: /07 Main Servo 8.4V/
File: 07_main_servo_8v4.kicad_sch
Title: Miuzei 8.4 V and MG90S 4.85 V Power Rails
