harrisontidy/pickleball-robot/simple_hobby_controller/pickleball_robot_simple.pdf

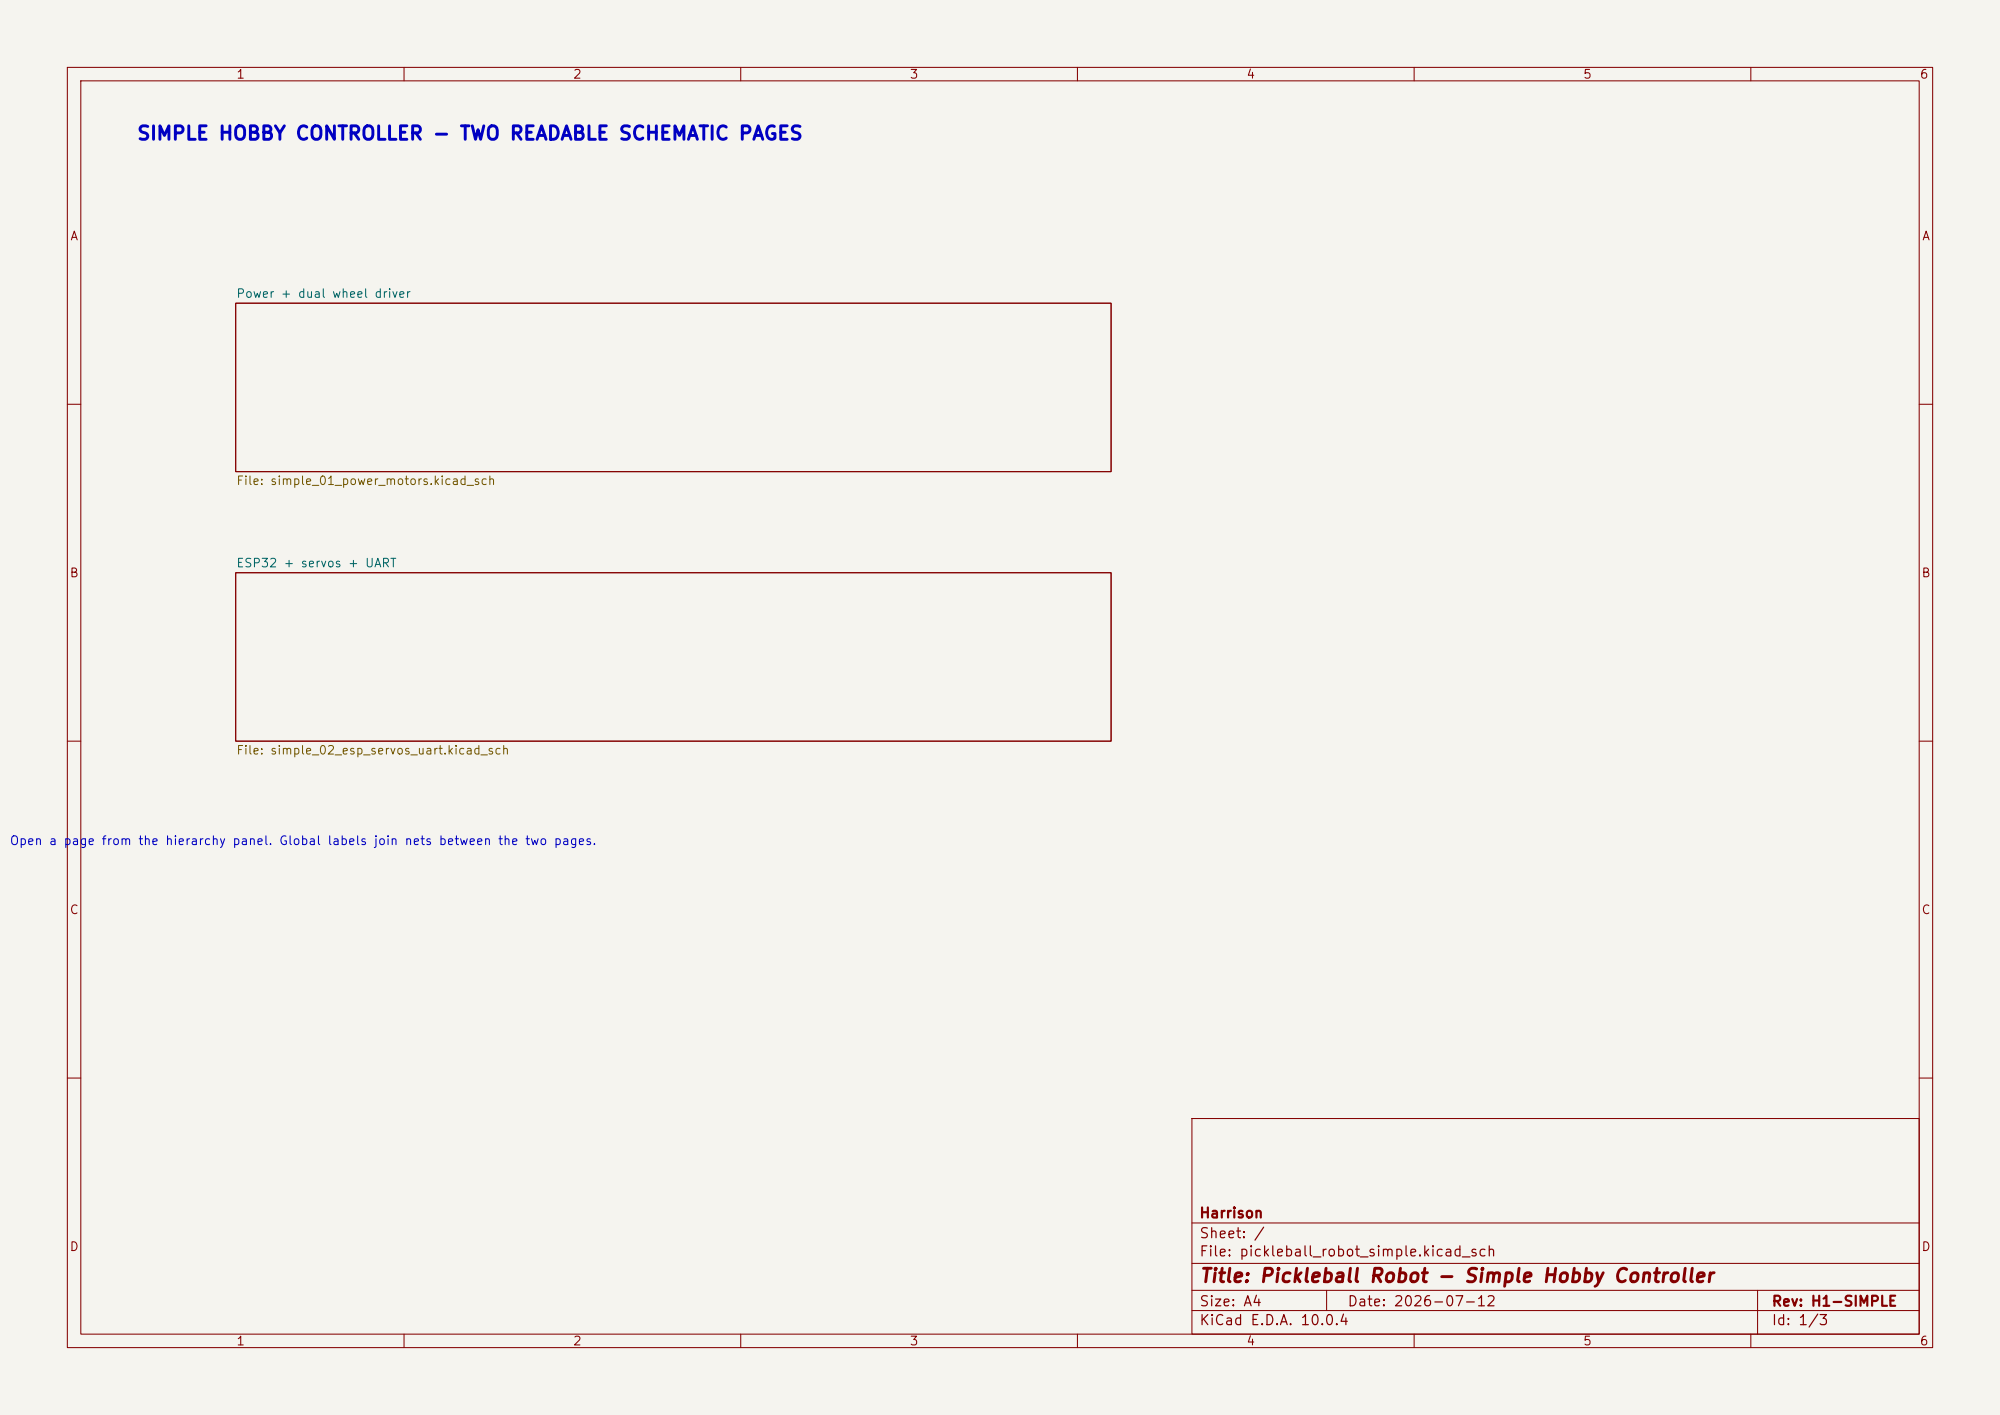
[picture p10: page 1]

SIMPLE HOBBY CONTROLLER - TWO READABLE SCHEMATIC PAGES

Power + dual wheel driver File: simple_01_power_motors.kicad_sch

Open a page from the hierarchy panel. Global labels join nets between the two pages.

Harrison
Sheet: /
File: pickleball_robot_simple.kicad_sch
Title: Pickleball Robot - Simple Hobby Controller

Size: A4 | Rev: H1-SIMPLE
KiCad E.D.A. 10.0.4 | Id: 1/3

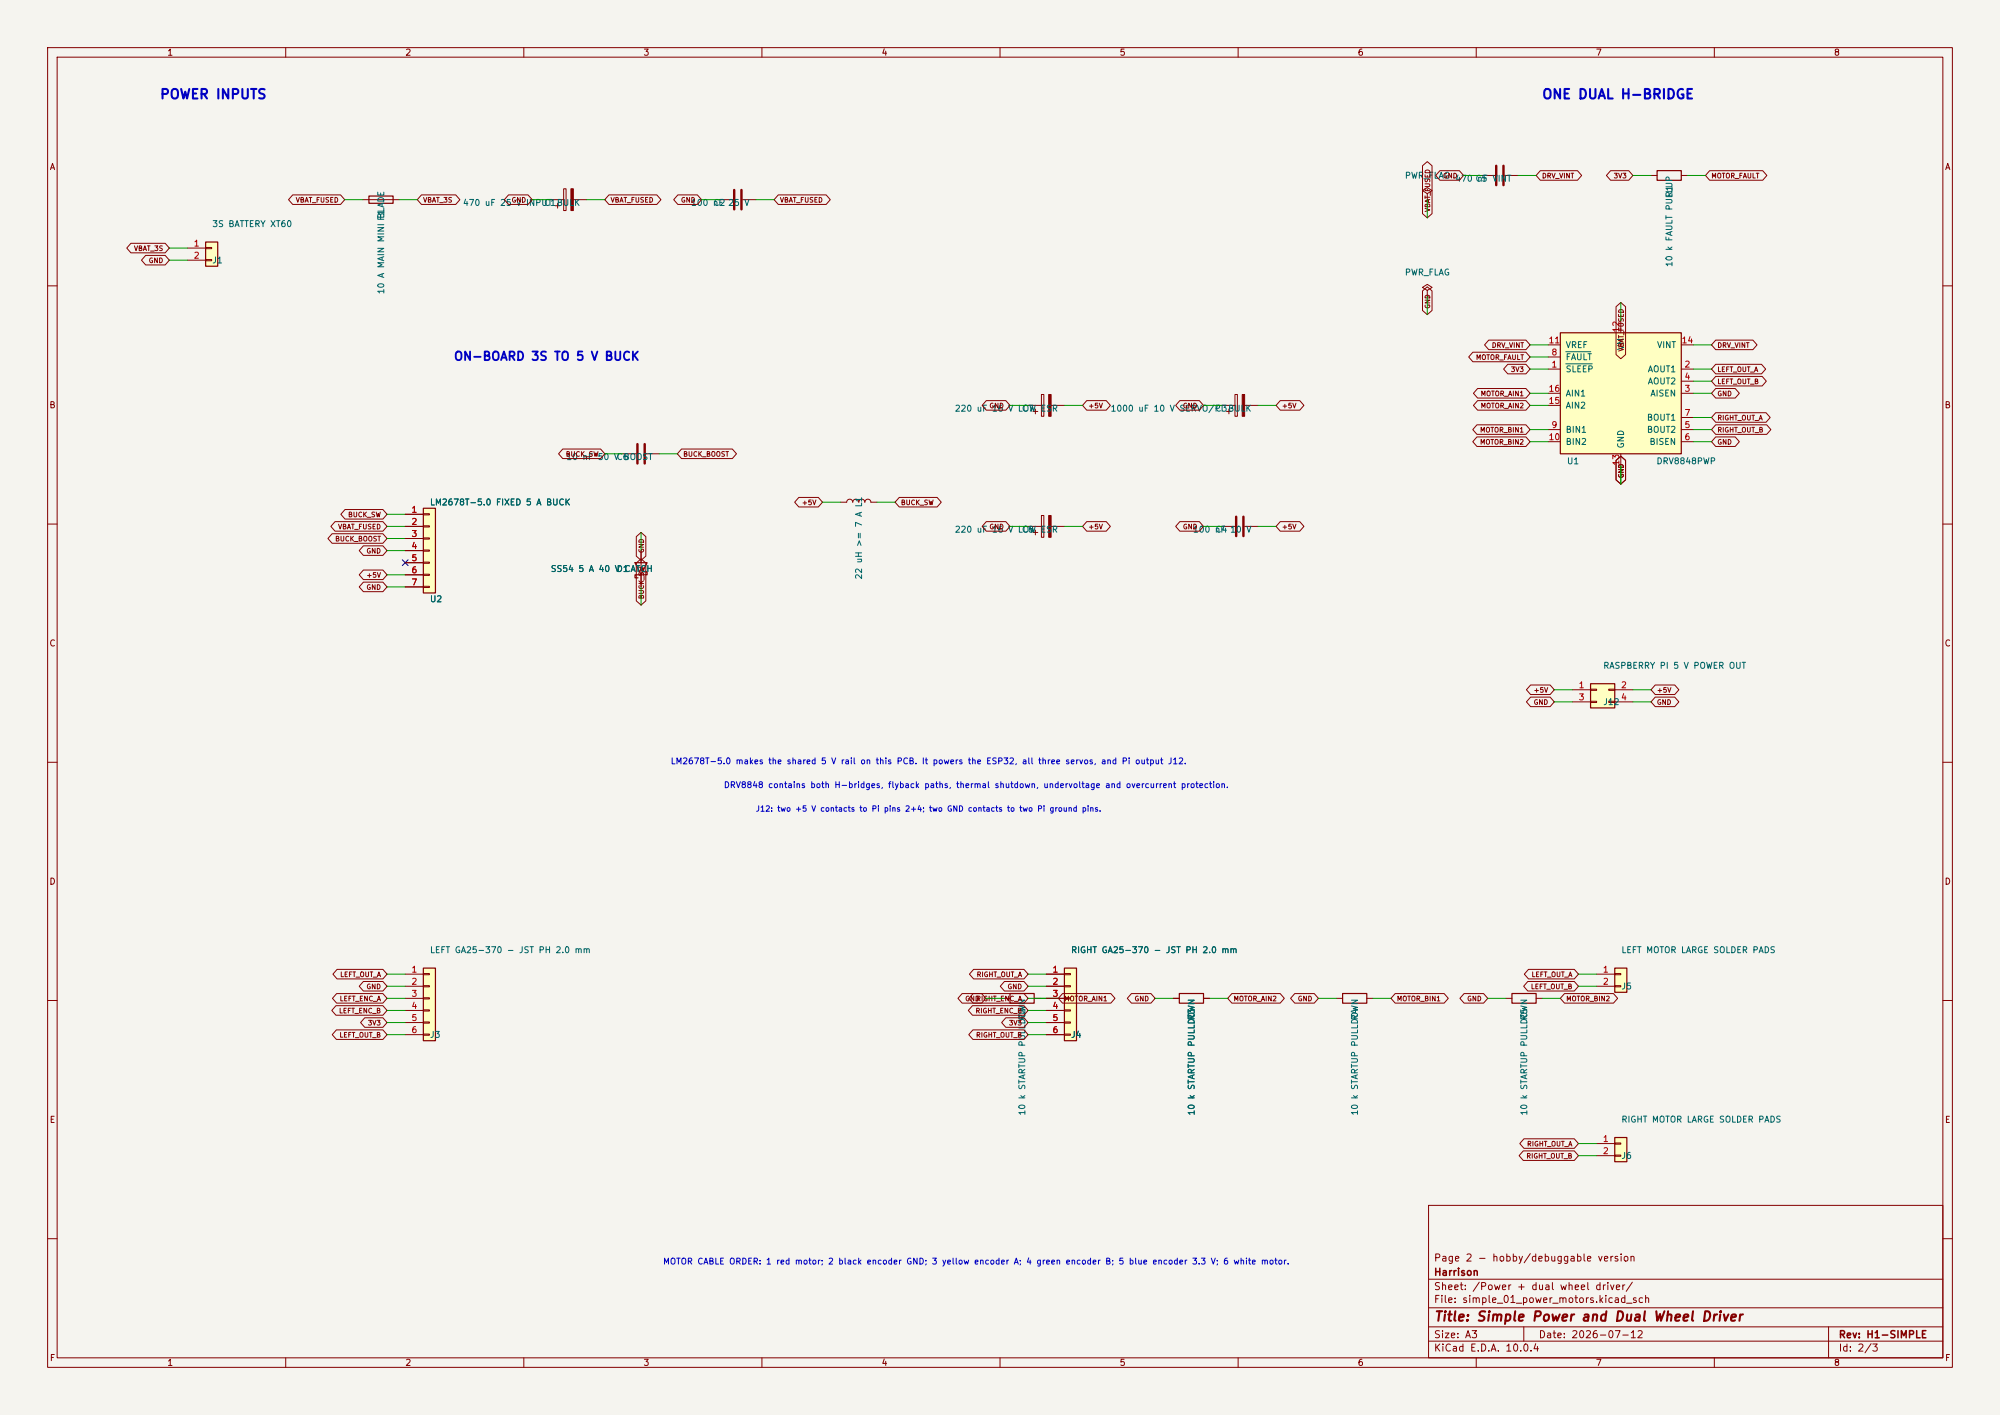
[picture p11: page 2]

ONE DUAL H-BRIDGE
J6RIGHT MOTOR LARGE SOLDER PADS R1 10 k FAULT PULLUPPWR_FLAG
470 C5nF VINT R4 10 k STARTUP PULLDOWN

ON-BOARD 3S TO 5 V BUCK

LEFT GA25-370 - JST PH 2.0 mm

Page 2 - hobby/debuggable version
Harrison
Sheet: /Power + dual wheel driver/
File: simple_01_power_motors.kicad_sch
Title: Simple Power and Dual Wheel Driver

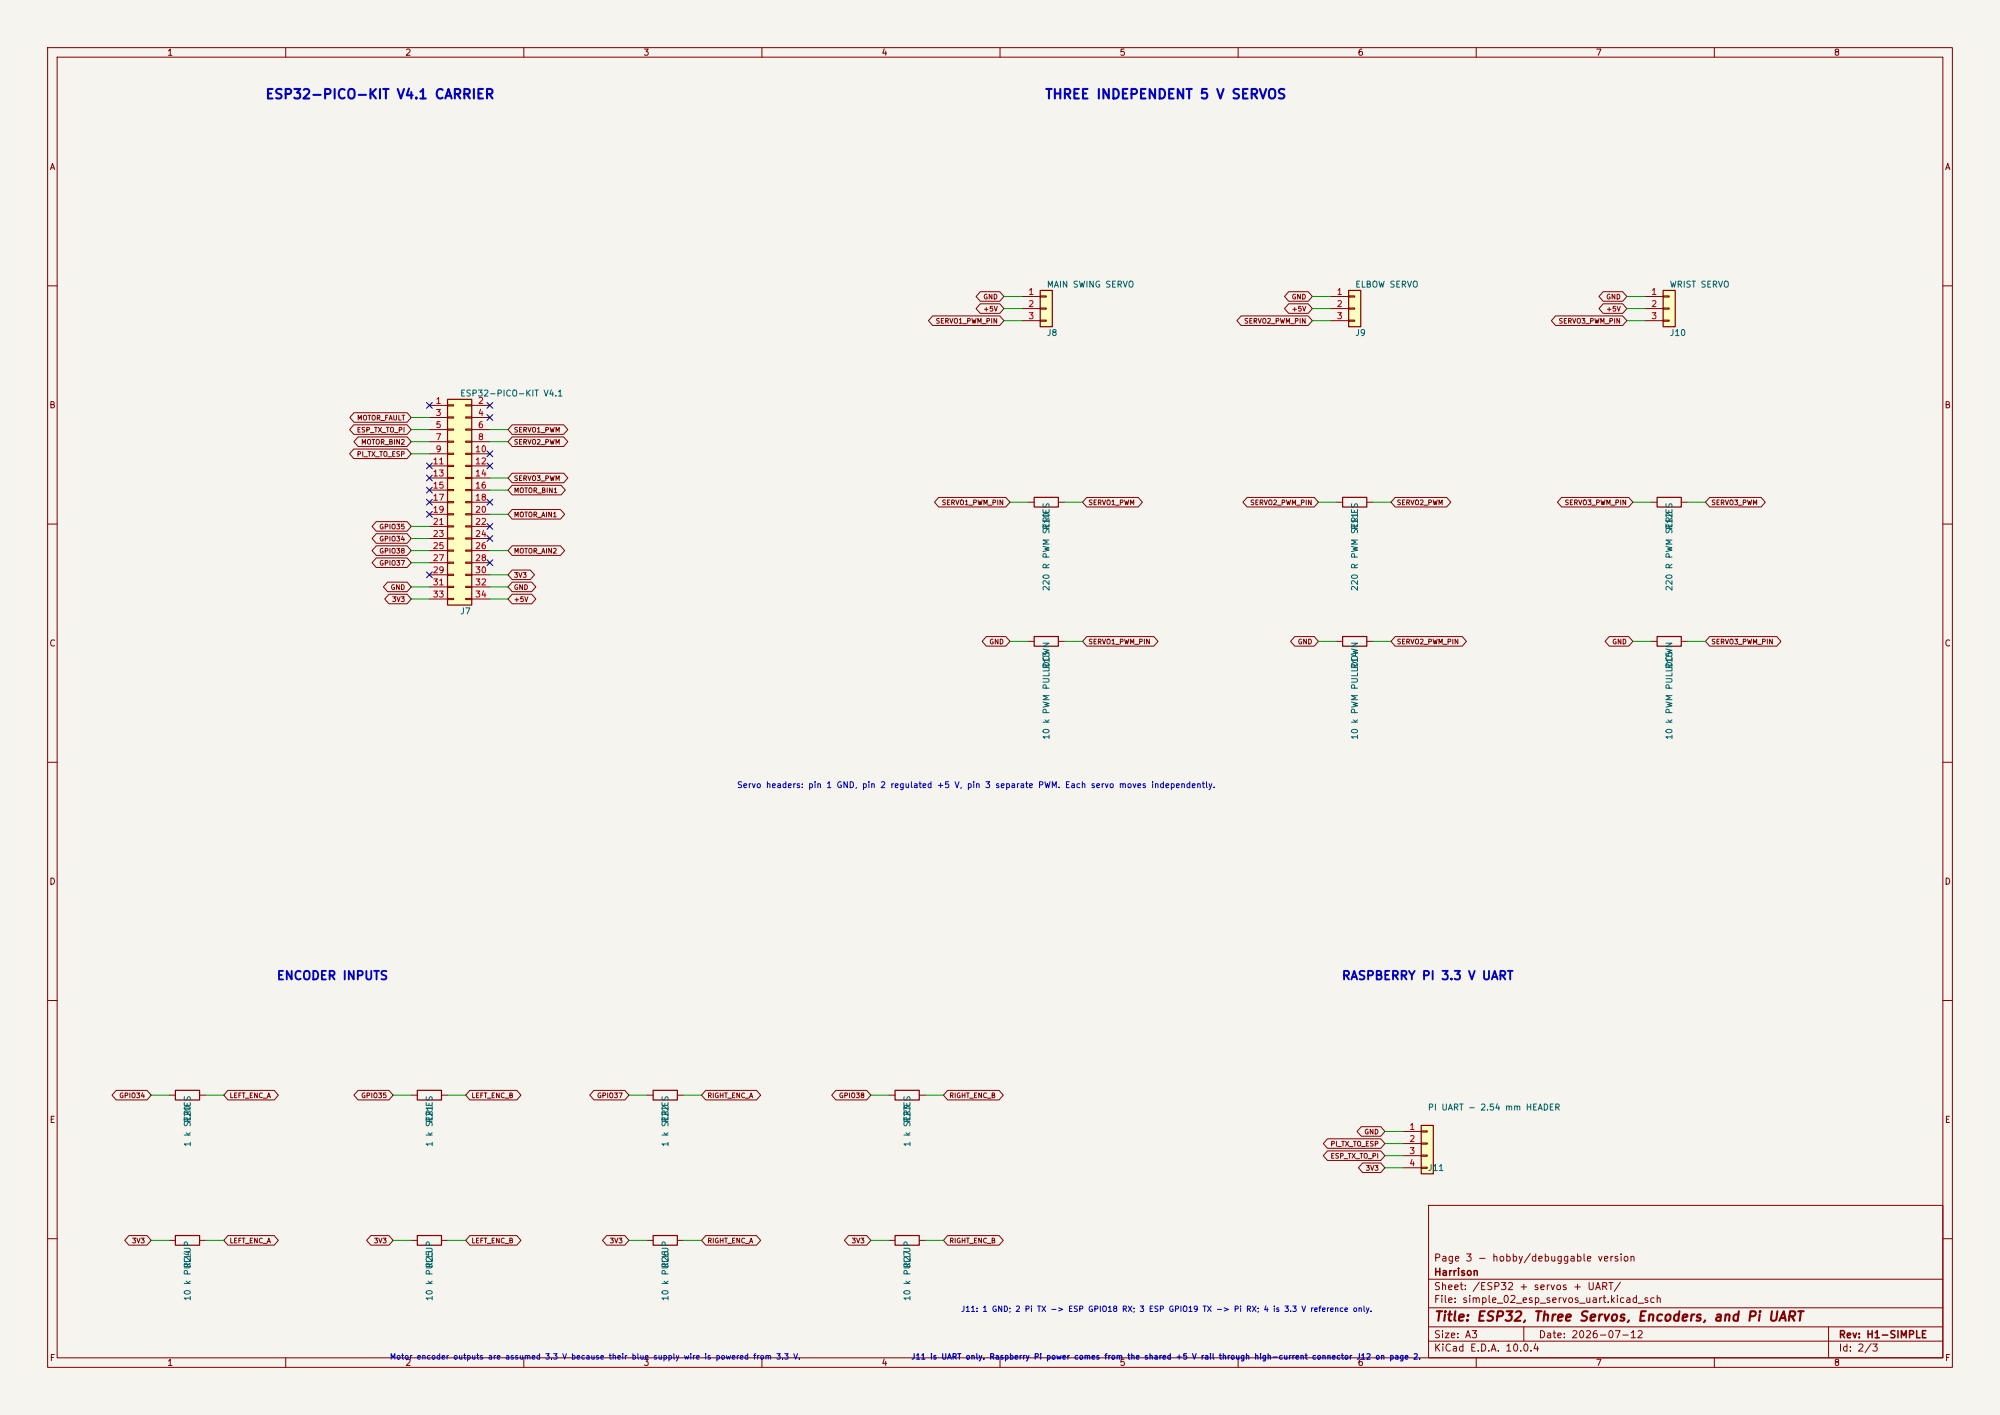
[picture p12: page 3]

J8MAIN SWING SERVO R26 10 k PULLUP R20 1 k SERIES

Servo headers: pin 1 GND, pin 2 regulated +5 V, pin 3 separate PWM. Each servo moves independently.

Harrison
Sheet: /ESP32 + servos + UART/
File: simple_02_esp_servos_uart.kicad_sch
Title: ESP32, Three Servos, Encoders, and Pi UART

J11: 1 GND; 2 Pi TX -> ESP GPIO18 RX; 3 ESP GPIO19 TX -> Pi RX; 4 is 3.3 V reference only. J11 is UART only. Raspberry Pi power comes from the shared +5 V rail through high-current connector J12 on page 2.
