harrisontidy/pickleball-robot/pcb/my turn.kicad_pcb

## KiCad design pcb/my turn.kicad_pcb (2026-10-11)

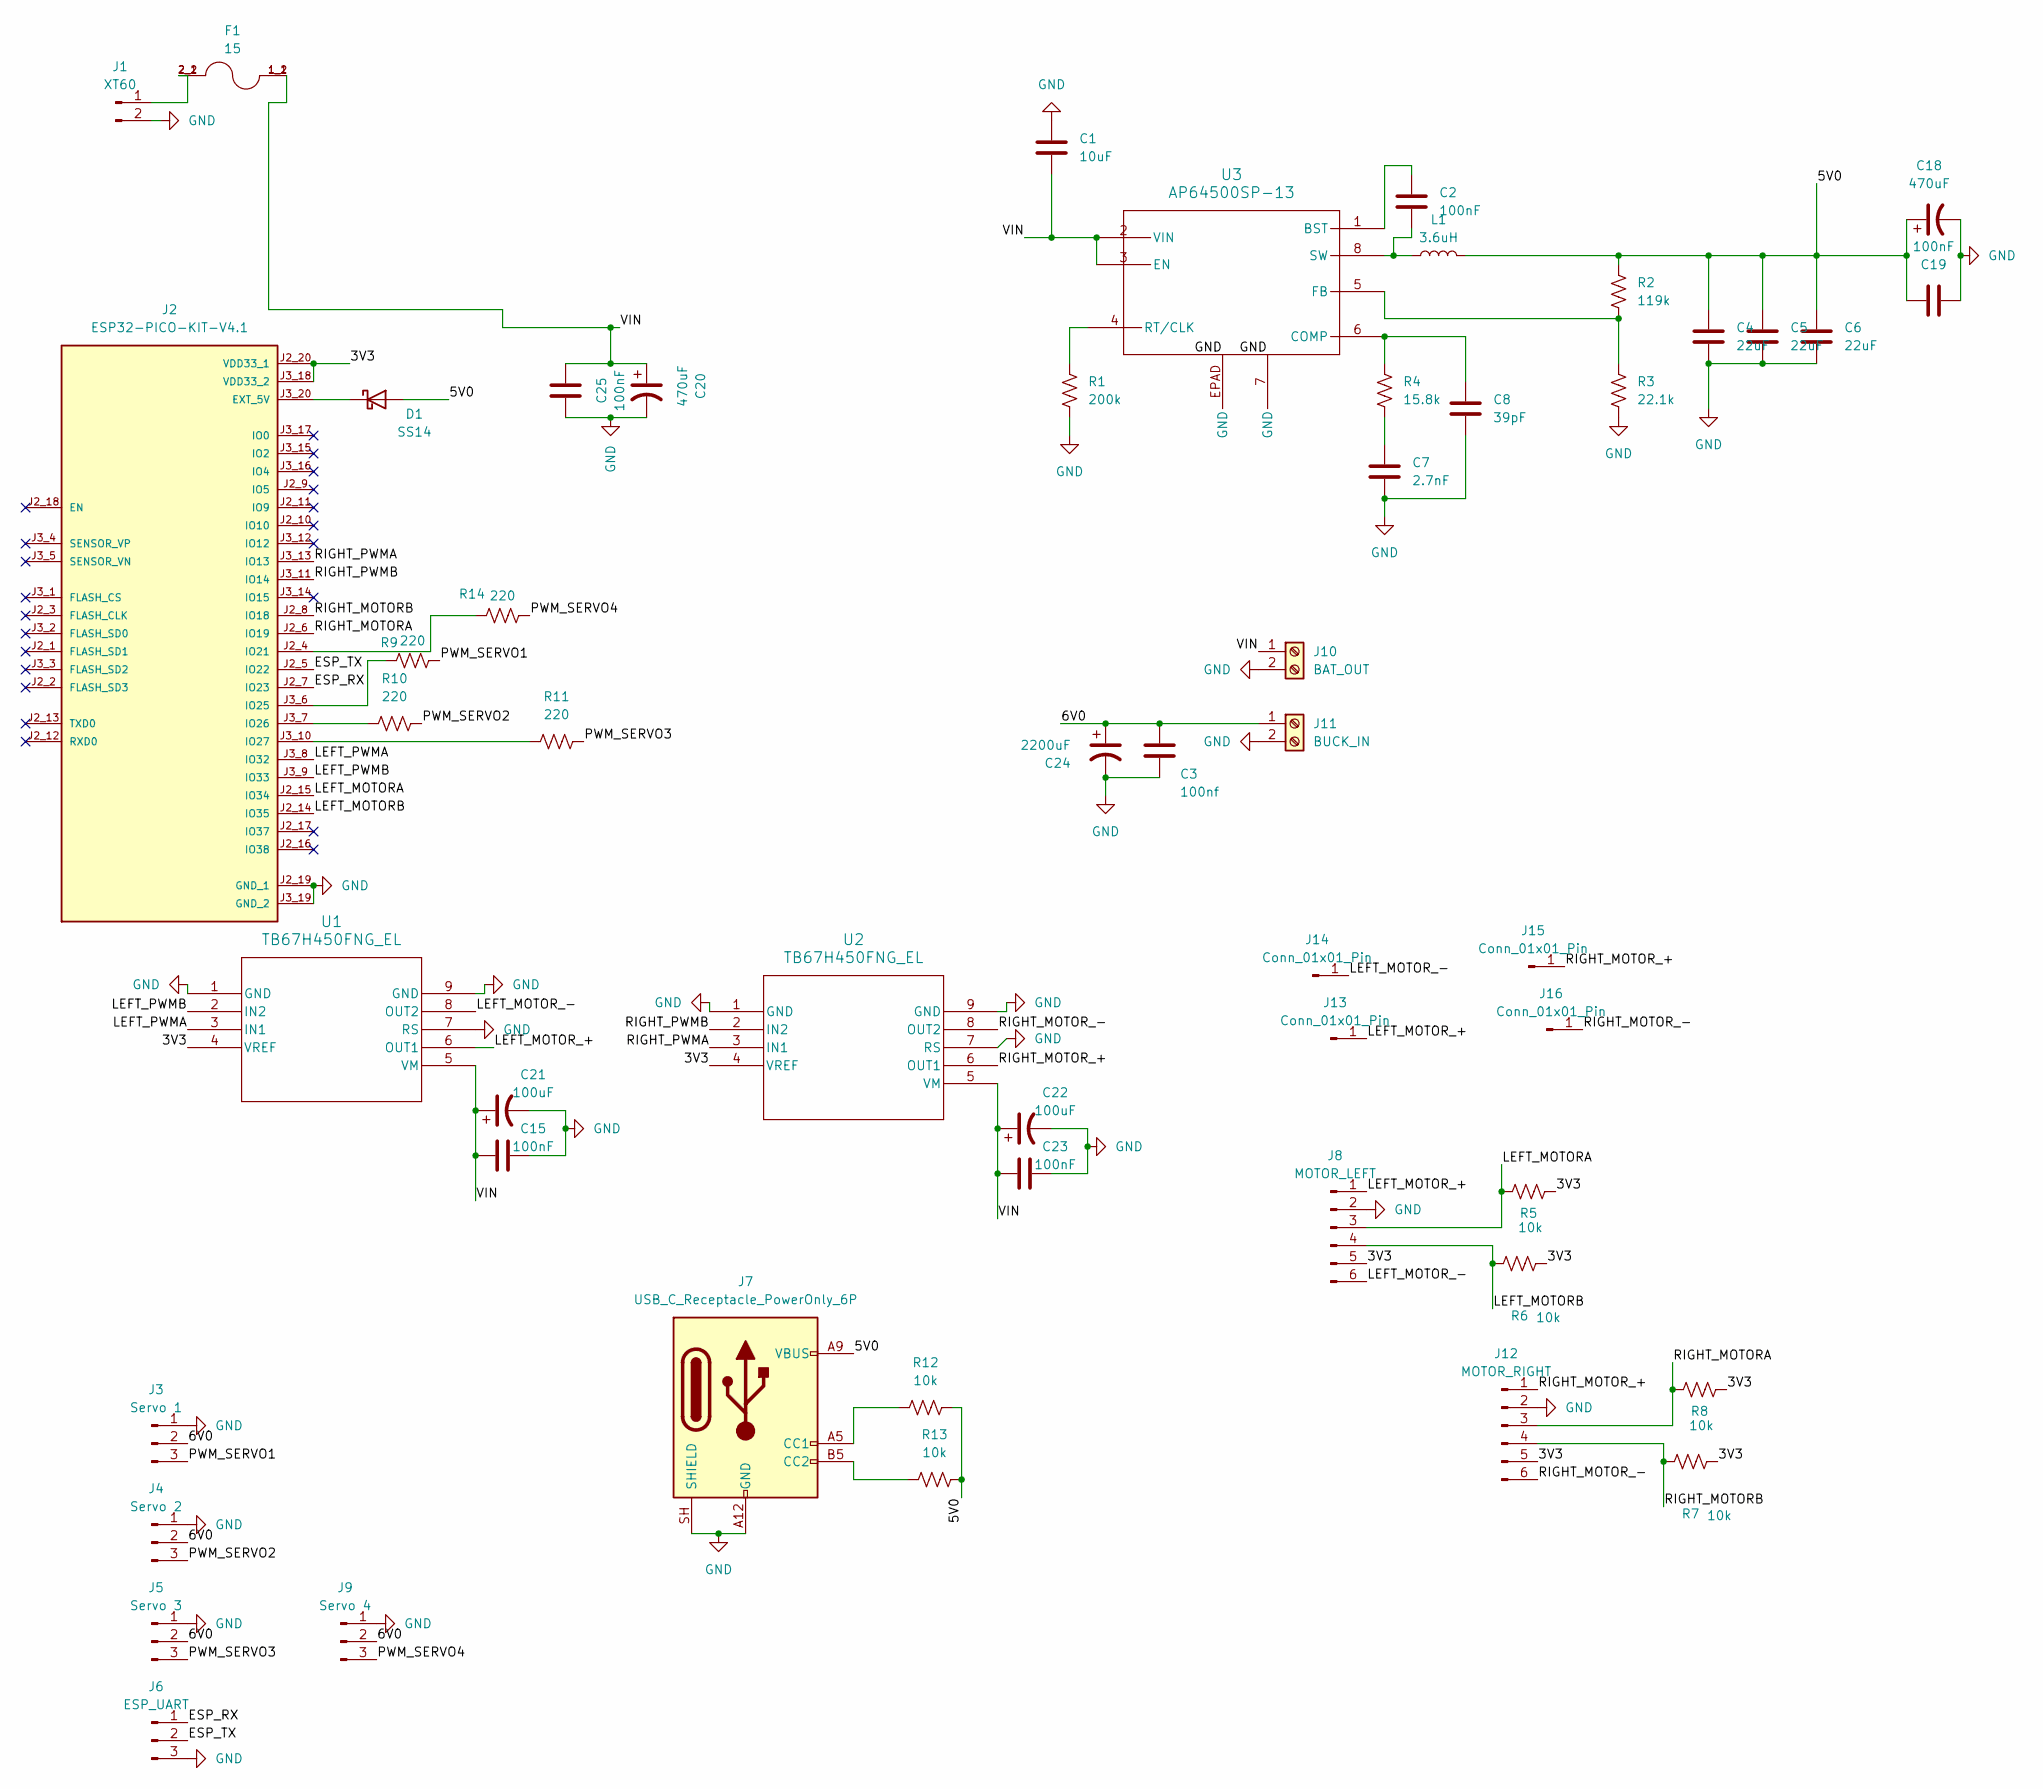
[picture p13: schematic my turn.kicad_sch]

Parts:
C1: 10uF; C_0805_2012Metric
C2, C15, C19, C23, C25: 100nF; C_0805_2012Metric
C3: 100nf; C_0805_2012Metric
C4, C5, C6: 22uF; C_0805_2012Metric
C7: 2.7nF; C_0805_2012Metric
C8: 39pF; C_0805_2012Metric
C18, C20: 470uF; CP_Radial_D10.0mm_P5.00mm
C21, C22: 100uF; CP_Radial_D8.0mm_P3.50mm
C24: 2200uF; CP_Radial_D12.5mm_P5.00mm
D1: SS14; D_SMA
F1: 15; FUSE_3587; PARTREV D
J1: XT60; AMASS_XT60-F_1x02_P7.20mm_Vertical
J2: ESP32-PICO-KIT-V4.1; XCVR_ESP32-PICO-KIT-V4.1; PARTREV 4.1
J3: Servo 1; PinHeader_1x03_P2.54mm_Vertical
J4: Servo 2; PinHeader_1x03_P2.54mm_Vertical
J5: Servo 3; PinHeader_1x03_P2.54mm_Vertical
J6: ESP_UART; PinHeader_1x03_P2.54mm_Vertical
J7: USB_C_Receptacle_PowerOnly_6P; USB_C_Receptacle_HRO_TYPE-C-31-M-17
J8: MOTOR_LEFT; JST_PH_B6B-PH-K_1x06_P2.00mm_Vertical
J9: Servo 4; PinHeader_1x03_P2.54mm_Vertical
J10: BAT_OUT; TerminalBlock_Phoenix_MKDS-1,5-2-5.08_1x02_P5.08mm_Horizont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
J11: BUCK_IN; TerminalBlock_Phoenix_MKDS-1,5-2-5.08_1x02_P5.08mm_Horizont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
J12: MOTOR_RIGHT; JST_PH_B6B-PH-K_1x06_P2.00mm_Vertical
J13, J14, J15, J16: Conn_01x01_Pin; Motor TH Pad
L1: 3.6uH; L_Sumida_CDRH127_L125
R1: 200k; R_0805_2012Metric
R2: 119k; R_0805_2012Metric
R3: 22.1k; R_0805_2012Metric
R4: 15.8k; R_0805_2012Metric
R5, R6, R7, R8, R12, R13: 10k; R_0805_2012Metric
R9, R10, R11, R14: 220; R_0805_2012Metric
U1, U2: TB67H450FNG_EL; P-HSOP8-0405-1p27-002_TOS
U3: AP64500SP-13; SO-8EP_DIO

Connections:
/3V3: J2.J2_20 (VDD33_1), J2.J3_18 (VDD33_2), J8.5, J12.5, R5.2, R6.2, R7.2, R8.2, U1.4 (VREF), U2.4 (VREF)
/5V0: C4.1, C5.2, C6.2, C18.1, C19.1, D1.2 (A), J7.A9 (VBUS), J7.B9 (VBUS), L1.2, R2.1, R12.2, R13.2
/6V0: C3.1, C24.1, J3.2, J4.2, J5.2, J9.2, J11.1
/ESP_RX: J2.J2_7 (IO23), J6.1
/ESP_TX: J2.J2_5 (IO22), J6.2
/LEFT_MOTORA: J2.J2_15 (IO34), J8.3, R5.1
/LEFT_MOTORB: J2.J2_14 (IO35), J8.4, R6.1
/LEFT_MOTOR_+: J8.1, J13.1 (Pin_1_1), U1.6 (OUT1)
/LEFT_MOTOR_-: J8.6, J14.1 (Pin_1_1), U1.8 (OUT2)
/LEFT_PWMA: J2.J3_8 (IO32), U1.3 (IN1)
/LEFT_PWMB: J2.J3_9 (IO33), U1.2 (IN2)
/PWM_SERVO1: J3.3, R9.2
/PWM_SERVO2: J4.3, R10.2
/PWM_SERVO3: J5.3, R11.2
/PWM_SERVO4: J9.3, R14.2
/RIGHT_MOTORA: J2.J2_6 (IO19), J12.3, R8.1
/RIGHT_MOTORB: J2.J2_8 (IO18), J12.4, R7.1
/RIGHT_MOTOR_+: J12.1, J15.1 (Pin_1_1), U2.6 (OUT1)
/RIGHT_MOTOR_-: J12.6, J16.1 (Pin_1_1), U2.8 (OUT2)
/RIGHT_PWMA: J2.J3_13 (IO13), U2.3 (IN1)
/RIGHT_PWMB: J2.J3_11 (IO14), U2.2 (IN2)
/VIN: C1.2, C15.2, C20.1, C21.1, C22.1, C23.2, C25.1, F1.1_1, F1.1_2, J10.1, U1.5 (VM), U2.5 (VM), U3.2 (VIN), U3.3 (EN)
GND: C1.1, C3.2, C4.2, C5.1, C6.1, C7.2, C8.2, C15.1, C18.2, C19.2, C20.2, C21.2, C22.2, C23.1, C24.2, C25.2, J1.2, J2.J2_19 (GND_1), J2.J3_19 (GND_2), J3.1, J4.1, J5.1, J6.3, J7.A12 (GND), J7.B12 (GND), J7.SH (SHIELD), J8.2, J9.1, J10.2, J11.2, J12.2, R1.2, R3.2, U1.1 (GND), U1.7 (RS), U1.9 (GND), U2.1 (GND), U2.7 (RS), U2.9 (GND), U3.7 (GND), U3.EPAD (GND)
unnamed: C7.1, R4.2
unnamed: D1.1 (K), J2.J3_20 (EXT_5V)
unnamed: F1.2_1, F1.2_2, J1.1
unnamed: J2.J2_4 (IO21), R14.1
unnamed: J2.J3_6 (IO25), R9.1
unnamed: J2.J3_7 (IO26), R10.1
unnamed: J2.J3_10 (IO27), R11.1
unnamed: J7.A5 (CC1), R12.1
unnamed: J7.B5 (CC2), R13.1
unnamed: C2.1, U3.1 (BST)
unnamed: C8.1, R4.1, U3.6 (COMP)
unnamed: R2.2, R3.1, U3.5 (FB)
unnamed: R1.1, U3.4 (RT/CLK)
unnamed: C2.2, L1.1, U3.8 (SW)

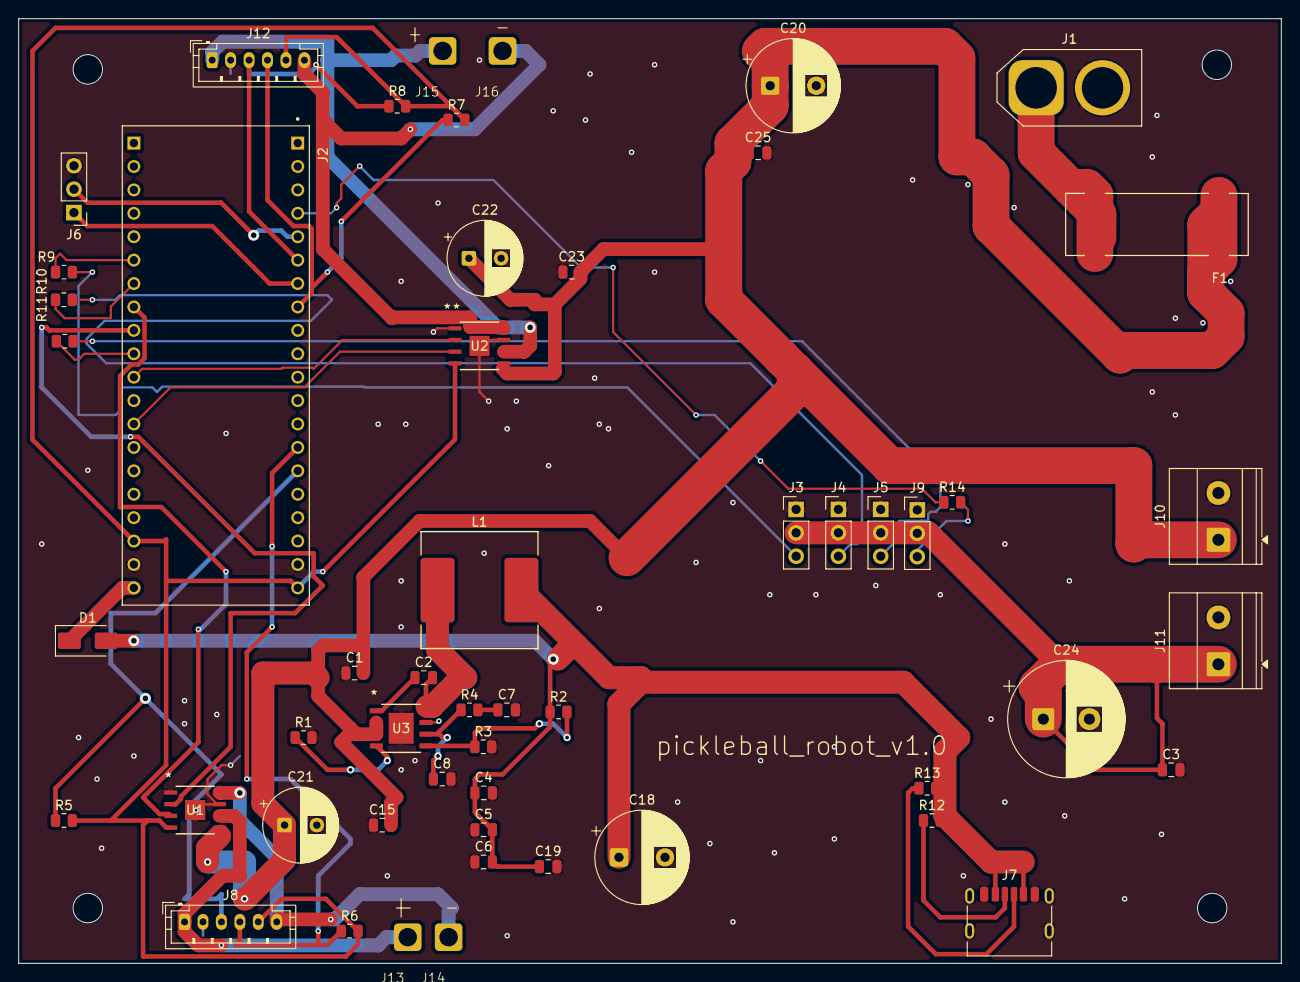
[picture p14: board my turn.kicad_pcb from above]

Board: 2 copper layers, 137.0 x 102.5 mm, 53 parts (0 on the bottom side), 37 nets.
