harrisontidy/pickleball-robot/(commit log)

2026-07-12 Add robot controller KiCad schematic and documentation
    [pickleball_robot_controller-bom.csv, pickleball_robot_controller.kicad_sch]
2026-07-12 Add prototype blue ball tracker
2026-07-12 Improve schematic readability and add power guidance
    [pickleball_robot_controller-bom.csv, pickleball_robot_controller.kicad_sch]
2026-07-12 Add Pi 5V buck design and clean schematic layout
    [pickleball_robot_controller-bom.csv, pickleball_robot_controller.kicad_sch]
2026-07-12 Right-size servo power and add motor cable connectors
    [pickleball_robot_controller-bom.csv, pickleball_robot_controller.kicad_sch]
2026-07-12 Correct GA25 motor connector to JST PH 2mm
    [pickleball_robot_controller-bom.csv, pickleball_robot_controller.kicad_sch]
2026-07-12 Use standard servo headers and solderable power parts
    [pickleball_robot_controller-bom.csv, pickleball_robot_controller.kicad_sch]
2026-07-12 Replace crowded schematic PDF with readable wiring book
2026-07-12 Render readable multi-sheet schematic PDF
2026-07-12 Rebuild controller as readable KiCad hierarchy
    [01_power_and_pi.kicad_sch, 02_esp32_and_pi.kicad_sch, 03_left_motor.kicad_sch, 04_right_motor.kicad_sch, 05_encoder_inputs.kicad_sch, 06_arm_servos.kicad_sch, pickleball_robot_controller-bom.csv, pickleball_robot_controller.kicad_sch]
2026-07-12 Correct motor cable pinout and add power solder pads
    [01_power_and_pi.kicad_sch, 02_esp32_and_pi.kicad_sch, 03_left_motor.kicad_sch, 04_right_motor.kicad_sch, 05_encoder_inputs.kicad_sch, 06_arm_servos.kicad_sch, pickleball_robot_controller-bom.csv, pickleball_robot_controller.kicad_sch]
2026-07-12 Add dedicated 8.4V rail for Miuzei main servo
    [01_power_and_pi.kicad_sch, 02_esp32_and_pi.kicad_sch, 03_left_motor.kicad_sch, 04_right_motor.kicad_sch, 05_encoder_inputs.kicad_sch, 06_arm_servos.kicad_sch, 07_main_servo_8v4.kicad_sch, pickleball_robot_controller-bom.csv]
2026-07-12 Complete pre-PCB electrical and safety audit
    [01_power_and_pi.kicad_sch, 02_esp32_and_pi.kicad_sch, 03_left_motor.kicad_sch, 04_right_motor.kicad_sch, 05_encoder_inputs.kicad_sch, 06_arm_servos.kicad_sch, 07_main_servo_8v4.kicad_sch, pickleball_robot_controller-bom.csv]
2026-07-12 Select robust 8.4V rail output capacitors
    [07_main_servo_8v4.kicad_sch, pickleball_robot_controller-bom.csv, pickleball_robot_controller.kicad_sch]
2026-07-12 Refresh generated schematic hierarchy
    [01_power_and_pi.kicad_sch, 02_esp32_and_pi.kicad_sch, 03_left_motor.kicad_sch, 04_right_motor.kicad_sch, 05_encoder_inputs.kicad_sch, 06_arm_servos.kicad_sch]
2026-07-12 Correct critical controller schematic safety issues
    [01_power_and_pi.kicad_sch, 02_esp32_and_pi.kicad_sch, 03_left_motor.kicad_sch, 04_right_motor.kicad_sch, 05_encoder_inputs.kicad_sch, 06_arm_servos.kicad_sch, 07_main_servo_8v4.kicad_sch, pickleball_robot_controller-bom.csv]
2026-07-13 Add whole-system battery cutoff and hardened servo interfaces
    [00_battery_safety.kicad_sch, 01_power_and_pi.kicad_sch, 02_esp32_and_pi.kicad_sch, 04_right_motor.kicad_sch, 05_encoder_inputs.kicad_sch, 06_arm_servos.kicad_sch, 07_main_servo_8v4.kicad_sch, pickleball_robot_controller-bom.csv]
2026-07-13 Add simple hobby controller KiCad design
    [pickleball_robot_simple-bom.csv, pickleball_robot_simple.kicad_sch, simple_01_power_motors.kicad_sch, simple_02_esp_servos_uart.kicad_sch]
2026-07-14 Add onboard shared 5V buck rail
    [pickleball_robot_simple-bom.csv, pickleball_robot_simple.kicad_sch, simple_01_power_motors.kicad_sch, simple_02_esp_servos_uart.kicad_sch]
2026-08-21 Record servo calibrations and safe idle
2026-10-11 Rebuild repository around current firmware and PCB
